Tesla900/CP_Inverter/PFC/Hardware/CP_inverter_front.png

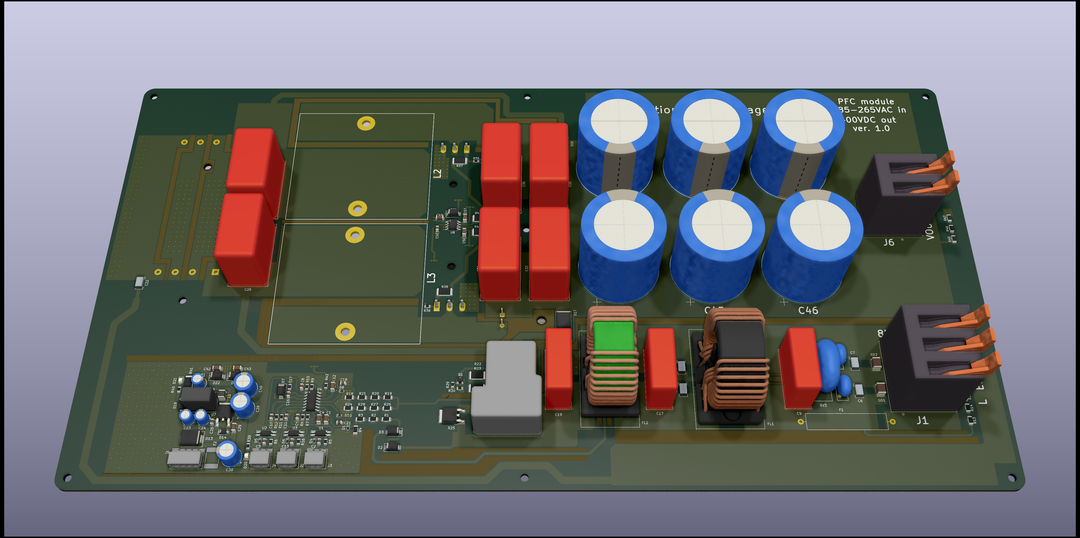
PFC/Hardware/CP_inverter_front.png
