Tesla900/CP_Inverter/PFC/Hardware/Info/CP_inverter_back.png

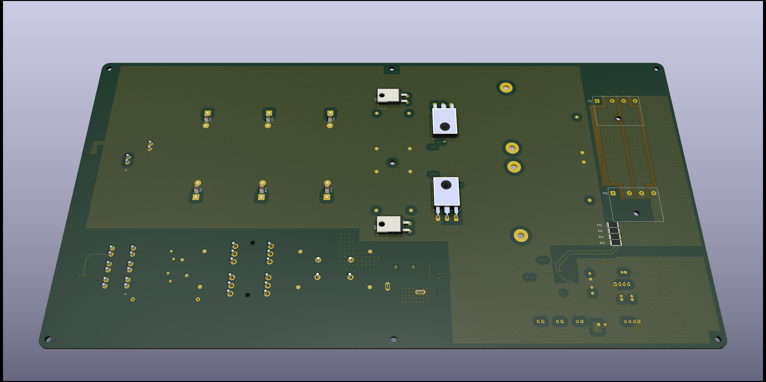
PFC/Hardware/Info/CP_inverter_back.png
