Tesla900/CP_Inverter/README.md

# CP_Inverter
Cathodic protection system project
