Tesla900/CP_Inverter/PFC/Hardware/Info/CP_inverter_front.png

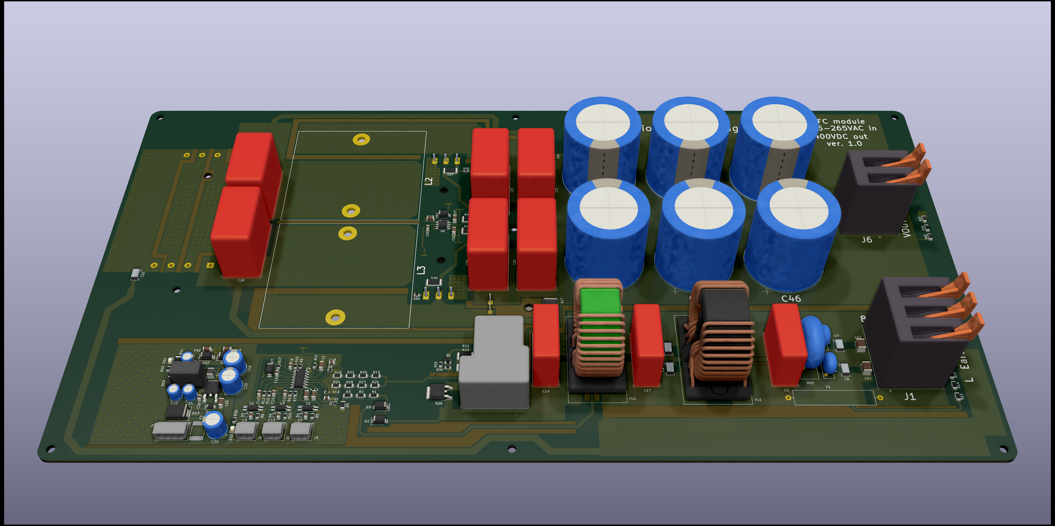
PFC/Hardware/Info/CP_inverter_front.png
