Tesla900/CP_Inverter/PSFB/Hardware/ProductionFiles/assembly/CP_Inverter_BOM.xlsx

Designator | PartNumber | Description | Value | Quantity | HelpURL
C1, C2, C3, C9, C11, C12, C14, C16, C17, C18, C32, C46, C47, C49, C51, C53, C54, C56, C58, C59, C60, C66, C68, C69, C71, C73, C74, C75, C81, C83, C84, C86, C88, C89, C90, C99, C100, C101, C102, C103 | CC1206KKX7R8BB106 | 10µF ±10% 25V Ceramic Capacitor X7R 1206 (3216 Metric) | 10μF | 40 | https://www.digikey.com/en/products/detail/yageo/CC1206KKX7R8BB106/5195365
C4, C7, C8, C15, C57, C72, C87 | CC0805JRNPO9BN270 | 27pF ±5% 50V Ceramic Capacitor C0G, NP0 0805 (2012 Metric) | 27pF | 7 | https://www.digikey.com/en/products/detail/yageo/CC0805JRNPO9BN270/302838
C5, C6, C50 | CC0805JKNPO7BN103 | 27pF ±5% 50V Ceramic Capacitor C0G, NP0 0805 (2012 Metric) | 10nF | 3 | https://www.digikey.com/en/products/detail/yageo/CC0805JKNPO7BN103/5884010
C10, C13, C52, C55, C67, C70, C82, C85, C96, C97, C98 | A750KS337M1EAAE018 | 330µF 25V Aluminum - Polymer Capacitors Radial, Can 18mOhm 2000 Hrs @ 105°C | 330μF | 11 | https://www.digikey.com/en/products/detail/kemet/A750KS337M1EAAE018/6196447
C19, C20, C21, C22, C23, C45, C48, C61, C62, C63, C64, C65, C76, C77, C78, C79, C80, C91, C92, C93, C94, C95 | CC0805JRNPO9BN101 | 100pF ±5% 50V Ceramic Capacitor C0G, NP0 0805 (2012 Metric) | 100pF | 22 | https://www.digikey.com/en/products/detail/yageo/CC0805JRNPO9BN101/302845
C24 | A750KS337M1EAAE018 | 22µF 450V Aluminum Electrolytic Capacitors Radial, Can 12000 Hrs @ 105°C | 22μF | 1 | https://www.digikey.com/en/products/detail/rubycon/450BXC22MEFC16X20/3564354
C25, C26, C27, C28 | 890303327008CS | 1.5µF Film Capacitor 630V Polypropylene (PP), Metallized RadialC | 1.5μF | 4 | https://www.digikey.com/en/products/detail/w%C3%BCrth-elektronik/890303327008CS/8324661
C29 | 8853522130111 | 1000pF ±10% 250V Ceramic Capacitor X7R 2211 (5728 Metric) | 1nF | 1 | https://www.digikey.com/en/products/detail/w%C3%BCrth-elektronik/8853522130111/6140841
C30, C39, C40, C41, C42, C43, C44 | CC1206KKX7R0BB225 | 2.2µF ±10% 100V Ceramic Capacitor X7R 1206 (3216 Metric) | 2.2μF | 7 | https://www.digikey.com/en/products/detail/yageo/CC1206KKX7R0BB225/5884563
C31 | CC0805KRX7R9BB104 | 0.1µF ±10% 50V Ceramic Capacitor X7R 0805 (2012 Metric) | 0.1μF | 1 | https://www.digikey.com/en/products/detail/yageo/CC0805KRX7R9BB104/302874
C33, C34, C35, C36, C37, C38 | LGY2A152MELB30 | 1500µF 100V Aluminum Electrolytic Capacitors Radial, Can - Snap-In 5000 Hrs @ 105°C | 1500μF | 6 | https://www.digikey.com/en/products/detail/nichicon/LGY2A152MELB30/2540916
D1 | B0303S-1WR2 | Isolated Module DC DC Converter 1 Output 3.3V 303mA 2.97V - 3.63V Input |  | 1 | https://lcsc.com/product-detail/Power-Modules_MORNSUN-Guangzhou-S-T-B0303S-1WR2_C70480.html
D2 | AMC1311BDWVR | Isolator amplifier |  | 1 | https://www.digikey.com/en/products/detail/texas-instruments/AMC1311BDWVR/8020495
D3, D9, D11, D13 | B2424S-1WR2 | Isolated Module DC DC Converter 1 Output 24V 42mA 21.6V - 26.4V Input |  | 4 | https://lcsc.com/product-detail/Power-Modules_MORNSUN-Guangzhou-S-T-B2424S-1WR2_C91799.html
D4, D10, D12, D14 | UCC21750DWR | 10A Gate Driver Capacitive Coupling 5700Vrms 1 Channel 16-SOIC |  | 4 | https://www.digikey.com/en/products/detail/texas-instruments/UCC21750DWR/11502037
D5 | CAS 50-NP | Current Sensor 50A 1 Channel Flux Gate, Closed Loop Bidirectional Module |  | 1 | https://www.digikey.com/en/products/detail/lem-usa-inc/CAS-50-NP/2038403
D6, D8 | 1EDN7512GXTMA1 | Low-Side Gate Driver IC Inverting, Non-Inverting PG-WSON-6-1 |  | 2 | https://www.digikey.com/en/products/detail/infineon-technologies/1EDN7512GXTMA1/6565754
D7 | AP2205-50W5-7 | Linear Voltage Regulator IC Positive Fixed 1 Output 250mA SOT-25 |  | 1 | https://www.digikey.com/en/products/detail/diodes-incorporated/AP2205-50W5-7/10294899
D15 | L7812CD2T-TR | Linear Voltage Regulator IC Positive Fixed 1 Output 1.5A D2PAK |  | 1 | https://www.digikey.com/en/products/detail/stmicroelectronics/L7812CD2T-TR/585702
D16 | LD1086D2T33TR | Linear Voltage Regulator IC Positive Fixed 1 Output 1.5A D2PAK |  | 1 | https://www.digikey.com/en/products/detail/stmicroelectronics/LD1086D2T33TR/585748
FU1 | C1Q 2.5 | 2.5A 125V AC 63V DC Fuse Board Mount (Cartridge Style Excluded) Surface Mount 1206 (3216 Metric) |  | 1 | https://www.digikey.com/en/products/detail/bel-fuse-inc/C1Q-2-5/615152
L1 | 0077930A7 | Custom inductor, DNP | *μH | 1 | http://ferrite.ru/warehouse/r-26-914-711-2-77930-a7.html
L2 | 0077438A7 | Custom inductor, DNP | *μH | 1 | http://ferrite.ru/warehouse/r-46-7-24-1-18-77438-a7.html
L3 | SDR0403-4R7ML | 4.7µH Unshielded Wirewound Inductor 1.7A 94mOhm Max Nonstandard | 4.7μH | 1 | https://www.digikey.com/product-detail/en/bourns-inc/SDR0403-4R7ML/SDR0403-4R7MLCT-ND/2127096
R1, R5, R13, R54, R69, R84 | RC0805JR-071KL | 1 kOhms ±5% 0.125W, 1/8W Chip Resistor 0805 (2012 Metric) Moisture Resistant Thick Film | 1K | 6 | https://www.digikey.com/en/products/detail/yageo/RC0805JR-071KL/728218
R2, R3, R4, R34 | RC0805FR-0749R9L | 49.9 Ohms ±1% 0.125W, 1/8W Chip Resistor 0805 (2012 Metric) Moisture Resistant Thick Film | 49.9R | 4 | https://www.digikey.com/en/products/detail/yageo/RC0805FR-0749R9L/727984
R6 | RC2512FK-0720R5L | 20.5 Ohms ±1% 1W Chip Resistor 2512 (6432 Metric) Moisture Resistant Thick Film | 20.5R | 1 | https://www.digikey.com/en/products/detail/yageo/RC2512FK-0720R5L/5921990
R7, R48, R63, R78 | RC2512JK-07220RL | 220 Ohms ±5% 1W Chip Resistor 2512 (6432 Metric) Moisture Resistant Thick Film | 220R | 4 | https://www.digikey.com/en/products/detail/yageo/RC2512JK-07220RL/5922529
R8, R20, R21, R23, R24, R30, R31, R38, R39, R40, R42, R45, R46, R49, R61, R62, R64, R76, R77, R79, R91, R92 | RC0805FR-0710KL | 10 kOhms ±1% 0.125W, 1/8W Chip Resistor 0805 (2012 Metric) Moisture Resistant Thick Film | 10K | 22 | https://www.digikey.com/en/products/detail/yageo/RC0805FR-0710KL/727535
R9, R10, R11, R50, R51, R52, R65, R66, R67, R80, R81, R82 | RC0805JR-074K7L | 4.7 kOhms ±5% 0.125W, 1/8W Chip Resistor 0805 (2012 Metric) Moisture Resistant Thick Film | 4.7K | 12 | https://www.digikey.com/en/products/detail/yageo/RC0805JR-074K7L/728327
R12, R14, R16, R17, R19, R37, R44, R53, R55, R57, R58, R60, R68, R70, R72, R73, R75, R83, R85, R87, R88, R90 | RC0805JR-07100RL | 100 Ohms ±5% 0.125W, 1/8W Chip Resistor 0805 (2012 Metric) Moisture Resistant Thick Film | 100R | 22 | https://www.digikey.com/product-detail/en/yageo/RC0805JR-07100RL/311-100ARCT-ND/731185
R15, R18, R56, R59, R71, R74, R86, R89 | RC2512JK-07100RL | 500 mOhms ±5% 1W Chip Resistor 2512 (6432 Metric) Automotive AEC-Q200, Current Sense, Moisture Resistant Thick Film | 0.5R | 8 | https://www.digikey.com/en/products/detail/yageo/RL2512JK-070R5L/5925490
R22, R25, R28 | RC1206FR-071ML | 1 MOhms ±1% 0.25W, 1/4W Chip Resistor 1206 (3216 Metric) Moisture Resistant Thick Film | 1M | 3 | https://www.digikey.com/en/products/detail/yageo/RC1206FR-071ML/728388
R26, R27, R32 | RC2512FK-07499RL | 499 Ohms ±1% 1W Chip Resistor 2512 (6432 Metric) Moisture Resistant Thick Film | 499R | 3 | https://www.digikey.com/en/products/detail/yageo/RC2512FK-07499RL/5922242
R29 | RC1206FR-0716K2L | 16.2 kOhms ±1% 0.25W, 1/4W Chip Resistor 1206 (3216 Metric) Moisture Resistant Thick Film | 16.2K | 1 | https://www.digikey.com/en/products/detail/yageo/RC1206FR-0716K2L/728570
R33 | RC1206JR-07100KL | 100 kOhms ±5% 0.25W, 1/4W Chip Resistor 1206 (3216 Metric) Moisture Resistant Thick Film | 100K | 1 | https://www.digikey.com/en/products/detail/yageo/RC1206JR-07100KL/729207
R35, R41 | RL1206JR-070R5L | 500 mOhms ±5% 0.25W, 1/4W Chip Resistor 1206 (3216 Metric) Automotive AEC-Q200, Current Sense, Moisture Resistant Thick Film | 0.5R | 2 | https://www.digikey.com/en/products/detail/yageo/RL1206JR-070R5L/5925150
R36, R43 | RC1206JR-073R3L | 3.3 Ohms ±5% 0.25W, 1/4W Chip Resistor 1206 (3216 Metric) Moisture Resistant Thick Film | 3.3R | 2 | https://www.digikey.com/en/products/detail/yageo/RC1206JR-073R3L/729266
R47 | RC0805FR-07412RL | 412 Ohms ±1% 0.125W, 1/8W Chip Resistor 0805 (2012 Metric) Moisture Resistant Thick Film | 412R | 1 | https://www.digikey.com/en/products/detail/yageo/RC0805FR-07412RL/727946
T1 | P8208NLT | 1:100 Current Sense Transformer 50kHz ~ 1MHz 6mOhm Primary, 5.5Ohm Secondary 2mH Surface Mount |  | 1 | https://www.digikey.com/product-detail/en/pulse-electronics-power/P8208NLT/553-1523-1-ND/2362921
T2 | B66398W1024T001 | N97 B66397G0000X197 сore / B66398W1024T001 coil former, DNP |  | 1 | https://www.digikey.com/en/products/detail/epcos-tdk-electronics/B66398W1024T001/3914904
VD1, VD2, VD4, VD27 | PESD3V3L1BA | 3.3V Reverse Standoff 26V Clamp 18A (8/20µs) Ipp Tvs Diode Surface Mount SOD-323 |  | 4 | https://www.digikey.com/en/products/detail/nexperia-usa-inc/PESD3V3L1BA-115/1157438
VD3 | BAT46WQ-7-F | Diode Schottky 100V 150mA Surface Mount SOD-123 |  | 1 | https://www.digikey.com/en/products/detail/diodes-incorporated/BAT46WQ-7-F/6003945
VD5, VD11, VD23, VD25, VD28, VD34, VD38, VD44, VD48, VD54 | 1N5819HW-7-F | Diode Schottky 40V 1A Surface Mount SOD-123C |  | 10 | https://www.digikey.com/en/products/detail/diodes-incorporated/1N5819HW-7-F/814970
VD6, VD29, VD39, VD49 | SMAZ16-13-F | Zener Diode 16V 1W ±5% Surface Mount SMA |  | 4 | https://www.digikey.com/en/products/detail/diodes-incorporated/SMAZ16-13-F/808526
VD7, VD30, VD40, VD50 | LTST-C171KRKT | Red 631nm LED Indication - Discrete 2V 0805 (2012 Metric) |  | 4 | https://www.digikey.com/en/products/detail/lite-on-inc/LTST-C171KRKT/386801
VD8, VD31, VD41, VD51 | SMAZ5V1-13-F | Zener Diode 5.1V 1W ±5% Surface Mount SMA |  | 4 | https://www.digikey.com/en/products/detail/diodes-incorporated/SMAZ5V1-13-F/725036
VD9, VD10, VD32, VD33, VD42, VD43, VD52, VD53 | STTH112A | Diode Standard 1200V 1A Surface Mount SMA |  | 8 | https://www.digikey.com/en/products/detail/stmicroelectronics/STTH112A/1039767
VD12, VD35, VD45, VD55 | MMSZ5242B | Zener Diode 12V 500mW ±5% Surface Mount SOD-123 |  | 4 | https://www.digikey.com/en/products/detail/on-semiconductor/MMSZ5242B/1048676
VD13, VD14, VD36, VD37, VD46, VD47, VD56, VD57 | LTST-C170GKT | Green 571nm LED Indication - Discrete 2V 0805 (2012 Metric) |  | 8 | https://www.digikey.com/en/products/detail/lite-on-inc/LTST-C171KGKT/386799
VD15, VD17, VD18, VD19, VD24, VD26 | SMBJ18CA | 29.2V Clamp 20.6A Ipp Tvs Diode Surface Mount DO-214AA (SMBJ) |  | 6 | https://www.digikey.com/en/products/detail/littelfuse-inc/SMBJ18CA/285986
VD16, VD20 | C6D04065E | Diode Silicon Carbide Schottky 650V 8A (DC) Surface Mount TO-252-2 |  | 2 | https://www.digikey.com/en/products/detail/cree-wolfspeed/C6D04065E/12525322
VD21, VD22 | MBRS4201T3G | Diode Schottky 200V 4A Surface Mount SMC |  | 2 | https://www.digikey.com/en/products/detail/on-semiconductor/MBRS4201T3G/1087352
VD58 | B340LB-13-F | Diode Schottky 40V 3A Surface Mount SMB |  | 1 | https://www.digikey.com/en/products/detail/diodes-incorporated/B340LB-13-F/755461
VD59 | SMBJ28CA | 45.4V Clamp 13.3A Ipp Tvs Diode Surface Mount DO-214AA (SMBJ) |  | 1 | https://www.digikey.com/en/products/detail/littelfuse-inc/SMBJ28CA/286003
VT1, VT2, VT3, VT4 | C3M0120065D | N-Channel 650V 22A (Tc) 98W (Tc) SiC MOSFET Through Hole TO-247-3 |  | 4 | https://www.richardsonrfpd.com/Products/Product/C3M0120065D
VT5, VT6 | IPT012N08N5ATMA1 | N-Channel 80V 300A (Tc) 375W (Tc) Surface Mount PG-HSOF-8-1 |  | 2 | https://www.digikey.com/en/products/detail/IPT012N08N5ATMA1/IPT012N08N5ATMA1CT-ND/5413752
X1, X2, X9, X12 | 60311002111526 | SMA Connector Jack, Female Socket 50Ohm Through Hole Solder |  | 4 | https://www.we-online.com/catalog/en/WR-SMA_60311002111526
X3 | 2453690000 | 2 Position Wire to Board Terminal Block Horizontal with Board 0.394" (10.00mm) Through Hole |  | 1 | https://www.digikey.com/en/products/detail/weidm%C3%BCller/2453690000/9637690
X4, X5, X6, X7 | SM06B-GHS | Connector Header Surface Mount, Right Angle 6 position 0.039" (1.00mm) |  | 4 | https://www.digikey.com/product-detail/en/jst-sales-america-inc/SM06B-GHS-TB-LF-SN/455-1568-1-ND/807836
X8, X13 | 7461098 | 25 Pin Shank Terminal M6 Through Hole |  | 2 | https://www.digikey.com/en/products/detail/w%C3%BCrth-elektronik/7461098/2092196
X10, X11 | SM02B-SRSS-TB(LF)(SN) | Connector Header Surface Mount, Right Angle 2 position 0.039" (1.00mm) |  | 2 | https://www.digikey.com/en/products/detail/jst-sales-america-inc/SM02B-SRSS-TB-LF-SN/926708
X14 | 6PCV-02-006 | 2 Circuit 0.375" (9.53mm) Barrier Block Connector, Screws |  | 1 | https://www.digikey.com/en/products/detail/te-connectivity-amp-connectors/6PCV-02-006/1277933
