Tesla900/CP_Inverter/PFC/Hardware/ProductionFiles/assembly/CP_Inverter_BOM.xlsx

Reference | Value/PartNumber | PartNumber | Qty | Description | Link | DoNotPlace Status
C2, C3, C11, C13, C26, C34 | 0.1uF | CC0805KRX7R9BB104 | 6 | 0.1µF ±10% 50V Ceramic Capacitor X7R 0805 (2012 Metric) | https://www.digikey.com/en/products/detail/yageo/CC0805KRX7R9BB104/302874
C10, C16 | 4.7nF | CC0805JKNPO8BN472 | 2 | 4700pF ±5% 25V Ceramic Capacitor C0G, NP0 0805 (2012 Metric) | https://www.digikey.com/en/products/detail/yageo/CC0805JKNPO8BN472/5884015
C6, C7, C14, C15 | 2.2nF | 8853522130151 | 4 | 2200pF ±10% 250V Ceramic Capacitor X7R 2211 (5728 Metric) | ttps://www.digikey.com/en/products/detail/würth-elektronik/8853522130151/6140842
C5, C8, C18 | 10nF | CC0805JKNPO7BN103 | 3 | 10nF ±5% 16V Ceramic Capacitor C0G, NP0 0805 (2012 Metric) | https://www.digikey.com/en/products/detail/yageo/CC0805JKNPO7BN103/5884010
C9, C17, C19 | 1.5uF | 890334026030 | 3 | 1.5µF Film Capacitor 310V Polypropylene (PP), X2 Rated, Metallized Radial | https://www.digikey.com/en/products/detail/w%C3%BCrth-elektronik/890334026030/5038988
C22, C55 | 1nF | 8853522130111 | 2 | 1000pF ±10% 250V Ceramic Capacitor X7R 2211 (5728 Metric) | https://www.digikey.com/en/products/detail/w%C3%BCrth-elektronik/8853522130111/6140841
C23, C24, C31 | 22uF | A768EB226M1HLAE048 | 3 | 22µF 35V Aluminum - Polymer Capacitors Radial, Can 80mOhm 2000 Hrs @ 125°C | https://www.digikey.com/en/products/detail/kemet/A759BQ226M1VAAE080/6196509
C27, C28, C32, C33, C35, C36 | 1.5uF | 890303327008CS | 6 | 1.5µF Film Capacitor 630V Polypropylene (PP), Metallized Radial | https://www.digikey.com/en/products/detail/w%C3%BCrth-elektronik/890303327008CS/8324661
C30, C39, C40 | 330uF | A750KS337M1EAAE018 | 3 | 330µF 25V Aluminum - Polymer Capacitors Radial, Can 18mOhm 2000 Hrs @ 105°C | https://www.digikey.com/en/products/detail/kemet/A750KS337M1EAAE018/6196447
C37, C38, C41, C44-C46 | 330uF | ETXH451VSN331MA40S | 6 | 330µF 450V Aluminum Electrolytic Capacitors Radial, Can - Snap-In 10000 Hrs @ 105°C | https://www.digikey.com/en/products/detail/united-chemi-con/ETXH451VSN331MA40S/5824661
C1, C4, C12, C20, C25, C29, C42, C43, C49, C56, C57 | 10uF | CC1206KKX7R8BB106 | 11 | 10µF ±10% 25V Ceramic Capacitor X7R 1206 (3216 Metric) | https://www.digikey.com/en/products/detail/yageo/CC1206KKX7R8BB106/5195365
C21, C50 | 22pF | CC0805JRNPO9BN220 | 2 | 22pF ±5% 50V Ceramic Capacitor C0G, NP0 0805 (2012 Metric) | https://www.digikey.com/en/products/detail/yageo/CC0805JRNPO9BN220/302837
C47, C48, C51-C54 | 0.1uF | C1210C104KBRACAUTO | 6 | 0.1µF ±10% 630V Ceramic Capacitor X7R 1210 (3225 Metric) | https://www.digikey.com/en/products/detail/kemet/C1210C104KBRACAUTO/7516214
D2, D3, D7, D19, D24 | MRA4007T3G | MRA4007T3G | 5 | Diode Standard 1000V 1A Surface Mount DO-214AC (SMA) | https://www.digikey.com/en/products/detail/on-semiconductor/MRA4007T3G/919869
D1, D4-D6, D8, D10 | PESD5V0L1UB,115 | PESD5V0L1UB,115 | 6 | 12V Clamp 3.5A (8/20µs) Ipp Tvs Diode Surface Mount SOD-523 | https://www.digikey.com/en/products/detail/nexperia-usa-inc/PESD5V0L1UB115/2092297
D11, D12 | 50A | TS50P07GHD2G | 2 | Bridge Rectifier Single Phase Standard 1kV 50A Through Hole TS-6P | https://www.digikey.com/en/products/detail/taiwan-semiconductor-corporation/TS50P07G-D2G/7359823
D13 | SMCJ30A | SMCJ30A | 1 | 48.4V Clamp 31A Ipp Tvs Diode Surface Mount DO-214AB (SMCJ) | https://www.digikey.com/en/products/detail/littelfuse-inc/SMCJ30A/762400
D9, D14 | 1N5819 | 1N5819HW-7-F | 2 | Diode Schottky 40V 1A Surface Mount SOD-123 | https://www.digikey.com/en/products/detail/diodes-incorporated/1N5819HW-7-F/814970
D15, D17 | S15MC V7G | S15MC V7G | 2 | Diode Standard 1000V 15A Surface Mount DO-214AB (SMC) | https://www.digikey.com/en/products/detail/taiwan-semiconductor-corporation/S15MC-V7G/7358295
D16, D18 | C6D10065A | C6D10065A | 2 | Diode Silicon Carbide Schottky 650V 37A (DC) Through Hole TO-220-2 | https://www.digikey.com/en/products/detail/C6D10065A/1697-C6D10065A-ND/10223723
D20, D21 | GREEN | LTST-S220KGKT | 2 | Green 568nm LED Indication - Discrete 2V 0805 (2012 Metric) | https://www.digikey.com/en/products/detail/lite-on-inc/LTST-S220KGKT/386875
D22 | 15V | SMAZ15 | 1 | Zener Diode 15V 1W ±5% Surface Mount SMA | https://www.digikey.com/en/products/detail/diodes-incorporated/SMAZ15-13-F/775753
D23 | 5.1V | SMAZ5V1 | 1 | Zener Diode 5.1V 1W ±5% Surface Mount SMA | https://www.digikey.com/en/products/detail/diodes-incorporated/SMAZ5V1-13-F/725036
F1 | 50A | SUT-H-6332-50A00-PGT-TT-NI | 1 | 50A 250V AC 70V DC Fuse Cartridge, Ceramic Through Hole 3AB, 3AG, 1/4" x 1-1/4" (Axial) | https://www.digikey.com/en/products/detail/schurter-inc/SUT-H-6332-50A00-PGT-TT-NI/9760595
F2 | 1A | 0ZCF0100AF2A | 1 | Polymeric PTC Resettable Fuse 60V 1A Ih Surface Mount 2920 (7351 Metric), Concave | https://www.digikey.com/en/products/detail/bel-fuse-inc/0ZCF0100AF2A/6210541
FL1 | 1.5mH@10kHz | 7448063801 | 1 | 1.5mH @ 10kHz 2 Line Common Mode Choke Through Hole 38A DCR 2.3mOhm | https://www.digikey.com/en/products/detail/w%C3%BCrth-elektronik/7448063801/4865370
FL2 | 500uH@10kHz | 7448263505 | 1 | 500µH @ 100kHz 2 Line Common Mode Choke Through Hole 35A DCR 2.3mOhm | https://www.digikey.com/en/products/detail/w%C3%BCrth-elektronik/7448263505/2682534
GD1, GD2 | SG500Q | SG500Q | 2 | Gas Discharge Tube 500V 1000A (1kA) 2 Pole Surface Mount | https://www.digikey.com/en/products/detail/littelfuse-inc/SG500Q/4286095
R31, R32 | ~ | ~ | 9 | ~ | ~ | DNP
J1 | 1988610000 | 1988610000 | 1 | 3 Position Wire to Board Terminal Block Horizontal with Board 0.394" (10.00mm) Through Hole | https://www.digikey.com/en/products/detail/weidm%C3%BCller/1988610000/9637680
J2-J4 | 0022057025 | 0022057025 | 3 | Connector Header Through Hole, Right Angle 2 position 0.098" (2.50mm) | https://www.digikey.com/en/products/detail/molex/0022057025/403341
J5 | 0022057045 | 0022057045 | 1 | Connector Header Through Hole, Right Angle 4 position 0.098" (2.50mm) | https://www.digikey.com/en/products/detail/molex/0022057045/403343
J6 | 2453690000 | 2453690000 | 1 | 2 Position Wire to Board Terminal Block Horizontal with Board 0.394" (10.00mm) Through Hole | https://www.digikey.com/en/products/detail/weidm%C3%BCller/2453690000/9637690
L1 | 6.8uH | LBC3225T6R8MR | 1 | 6.8µH Unshielded Wirewound Inductor 620mA 120mOhm 1210 (3225 Metric) | https://www.digikey.com/en/products/detail/taiyo-yuden/LBC3225T6R8MR/2230218
L2, L3 | 250uH | 0058620A2 | 2 | Custom 25A 250uH inductor. Use 2 stacked HighFlux cores (KS250-060A or 0077617A7) and make 22 turns with 2.5mm2 emal wire | https://www.mag-inc.com/Media/Magnetics/Datasheets/0058620A2.pdf
Q1 | IRLML0030TRPBF | IRLML0030TRPBF | 1 | N-Channel 30V 5.3A (Ta) 1.3W (Ta) Surface Mount Micro3™/SOT-23 | https://www.digikey.com/en/products/detail/infineon-technologies/IRLML0030TRPBF/2202215
Q2, Q3 | C3M0060065D | C3M0060065D | 2 | N-Channel SiC 650V 37A (Tc) 150W (Tc) Through Hole TO-247-3 | https://www.digikey.com/en/products/detail/cree-wolfspeed/C3M0060065D/12525330
R4 | 47.5K | RC1206FR-0747K5L | 1 | 47.5 kOhms ±1% 0.25W, 1/4W Chip Resistor 1206 (3216 Metric) Thick Film | https://www.digikey.com/en/products/detail/yageo/RC1206FR-0747K5L/728933
R5, R6, R11, R16, R29 | 470R | RC0805JR-07470RL | 5 | 470 Ohms ±5% 0.125W, 1/8W Chip Resistor 0805 (2012 Metric) Thick Film | https://www.digikey.com/en/products/detail/yageo/RC0805JR-07470RL/728333
R8 | 6.2K | RC0805FR-076K2L | 1 | 6.2 kOhms ±1% 0.125W, 1/8W Chip Resistor 0805 (2012 Metric) Thick Film | https://www.digikey.com/en/products/detail/yageo/RC0805FR-076K2L/728055
R9, R10 | 200K | RC0805FR-07200KL | 2 | 200 kOhms ±1% 0.125W, 1/8W Chip Resistor 0805 (2012 Metric) Thick Film | https://www.digikey.com/en/products/detail/yageo/RC0805FR-07200KL/727724
R12 | 47.5K | RC0805FR-0747K5L | 1 | 10 kOhms ±5% 0.125W, 1/8W Chip Resistor 0805 (2012 Metric) Thick Film | https://www.digikey.com/en/products/detail/yageo/RC0805FR-0747K5L/727975
R17 | 68R | RC0805FR-0768RL | 1 | 100 Ohms ±1% 0.125W, 1/8W Chip Resistor 0805 (2012 Metric) Thick Film | https://www.digikey.com/en/products/detail/yageo/RC0805FR-0768RL/728097
R18 | 18.7K | RC1206FR-0718K7L | 1 | 18.7 kOhms ±1% 0.25W, 1/4W Chip Resistor 1206 (3216 Metric) Thick Film | https://www.digikey.com/en/products/detail/yageo/RC1206FR-0718K7L/728596
R1-R3, R13-R15, R19-R21, R26-R28, R45-R47 | 1M | RC1206FR-071ML | 15 | 1 MOhms ±1% 0.25W, 1/4W Chip Resistor 1206 (3216 Metric) Thick Film | https://www.digikey.com/en/products/detail/yageo/RC1206FR-071ML/728388
R22, R23 | 33R | SR2512FK-7W33RL | 2 | 33 Ohms ±1% 2W Chip Resistor 2512 (6432 Metric) Automotive AEC-Q200, Pulse Withstanding Thick Film | https://www.digikey.com/en/products/detail/yageo/SR2512FK-7W33RL/9373196
R24 | 17.4K | RC1206FR-0717K4L | 1 | 17.4 kOhms ±1% 0.25W, 1/4W Chip Resistor 1206 (3216 Metric) Thick Film | https://www.digikey.com/en/products/detail/yageo/RC1206FR-0717K4L/728584
R25 | 25R | PWR163S-25-25R0FE | 1 | 25 Ohms ±1% 25W Chip Resistor TO-252-3, DPak (2 Leads + Tab), SC-63 Automotive AEC-Q200, Current Sense, Pulse Withstanding Thick Film | https://www.digikey.com/en/products/detail/bourns-inc/PWR163S-25-25R0FE/4699567
R33, R34 | 0.009R | SY2512CFR009 | 2 | 9 mOhms ±1% ±50ppm/°C 3W Chip Resistor 2512 (6432 Metric), Current Sense, Thick Film | https://lcsc.com/product-detail/Low-Resistors-Current-Sense-Resistors-Surface-Mount_SANYEAR-SY2512CFR009_C457123.html
R7, R30, R35, R36, R39, R40 | 10K | RC0805JR-0710KL | 6 | 10 kOhms ±5% 0.125W, 1/8W Chip Resistor 0805 (2012 Metric) Thick Film | https://www.digikey.com/en/products/detail/yageo/RC0805JR-0710KL/728241
R37, R38, R43, R44 | 0.5R | RL2512JK-070R5L | 4 | 500 mOhms ±5% 1W Chip Resistor 2512 (6432 Metric) Automotive AEC-Q200, Current Sense, Moisture Resistant Thick Film | https://www.digikey.com/en/products/detail/yageo/RL2512JK-070R5L/5925490
R41 | 220R | RC2512JK-07220RL | 1 | 220 Ohms ±5% 1W Chip Resistor 2512 (6432 Metric) Thick Film | https://www.digikey.com/en/products/detail/yageo/RC2512JK-07220RL/5922529
R42 | 100R | RC0805FR-07100RL | 1 | 100 Ohms ±1% 0.125W, 1/8W Chip Resistor 0805 (2012 Metric) Thick Film | https://www.digikey.com/en/products/detail/yageo/RC0805FR-07100RL/727543
RV1, RV2 | 820471511 | 820471511 | 2 | 240V 1.75kA Varistor 1 Circuit Through Hole Disc 7mm | https://www.digikey.com/en/products/detail/würth-elektronik/820471511/9817446
RV3 | 820422711 | 820422711 | 1 | 430V 10kA Varistor 1 Circuit Through Hole Disc 20mm | https://www.digikey.com/en/products/detail/w%C3%BCrth-elektronik/820422711/9817436
U1-U3 | LTV-217-C | LTV-217-C-G | 3 | Optoisolator Transistor Output 3750Vrms 1 Channel 4-SSOP | https://www.digikey.com/en/products/detail/lite-on-inc/LTV-217-C-G/4573246
U4 | ICE3PCS01G | ICE3PCS01G | 1 | PFC IC Continuous Conduction (CCM) 21kHz - 100kHz PG-DSO-14 | https://www.digikey.com/en/products/detail/infineon-technologies/ICE3PCS01GXUMA1/5413671
U5 | T9VV1K15-12S | T9VV1K15-12S | 1 | General Purpose Relay SPST-NO (1 Form A) 40A 12VDC Coil Through Hole | https://www.digikey.com/en/products/detail/te-connectivity-potter-brumfield-relays/T9VV1K15-12S/7793533
U6 | L7815ACD2T | L7815ACD2T | 1 | Linear Voltage Regulator IC 1 Output 15V 1.5A D2PAK | https://www.digikey.com/en/products/detail/stmicroelectronics/L7815ACD2T-TR/1663423
U7 | B2424-1WR2 | B2424S-1WR2 | 1 | Isolated Module DC/DC Converter 1 Output 24V 42mA 21.6V - 26.4V Input | https://lcsc.com/product-detail/Power-Modules_MORNSUN-Guangzhou-S-T-B2424S-1WR2_C91799.html
U8 | UCC5390SCD | UCC5390SCD | 1 | 17A Gate Driver Capacitive Coupling 3000Vrms 1 Channel 8-SOIC | https://www.digikey.com/en/products/detail/texas-instruments/UCC5390SCD/8106211
DNP -Do Not Place
