Tesla900/CP_Inverter/PSFB/Hardware/Info/PSFB_Schematic Print.PDF

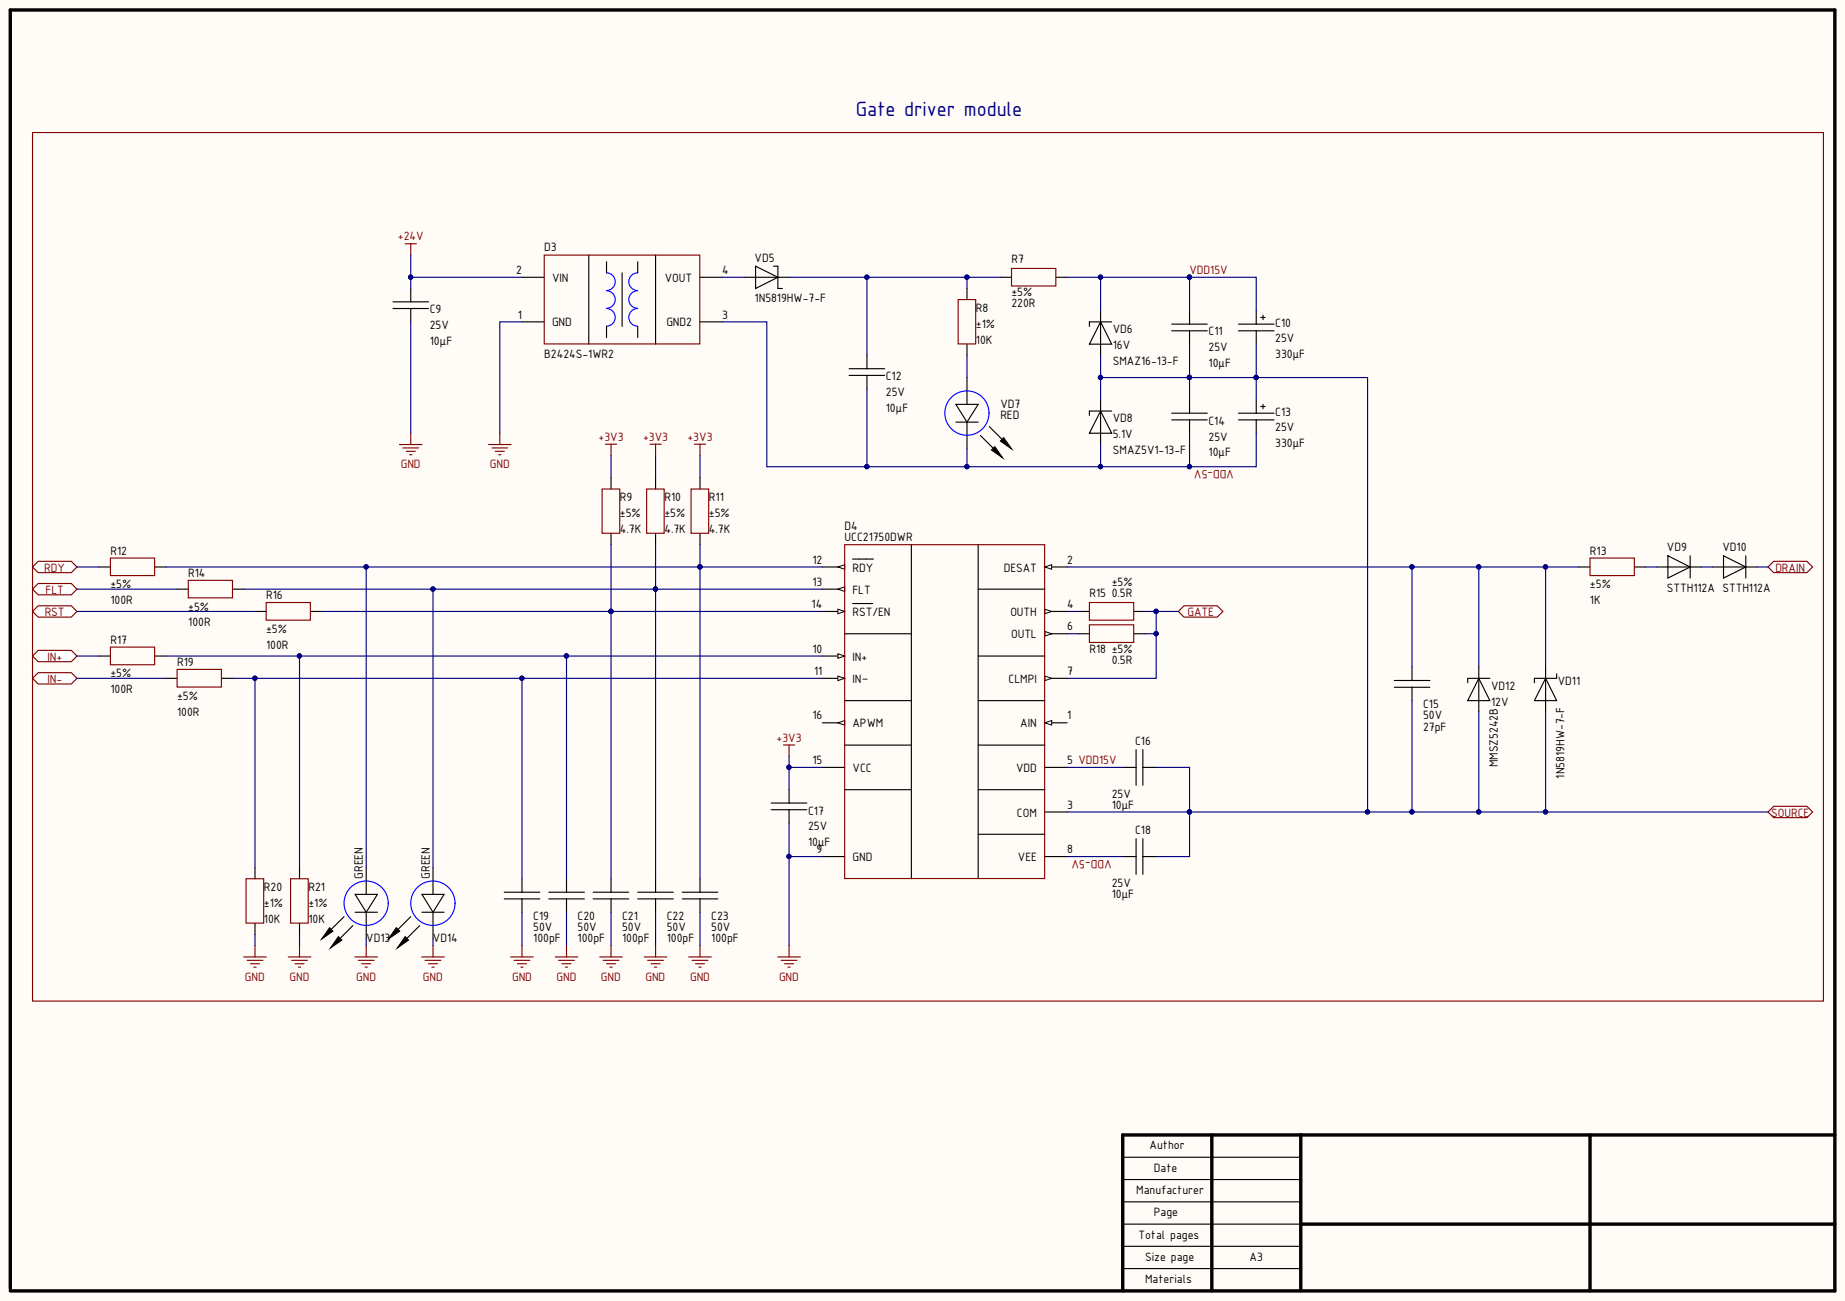
[picture p4: page 1]

+3V3 | APWM 16 | 1 C16

Author

Date

Manufacturer

Page

Total pages

Size page | A3

Materials

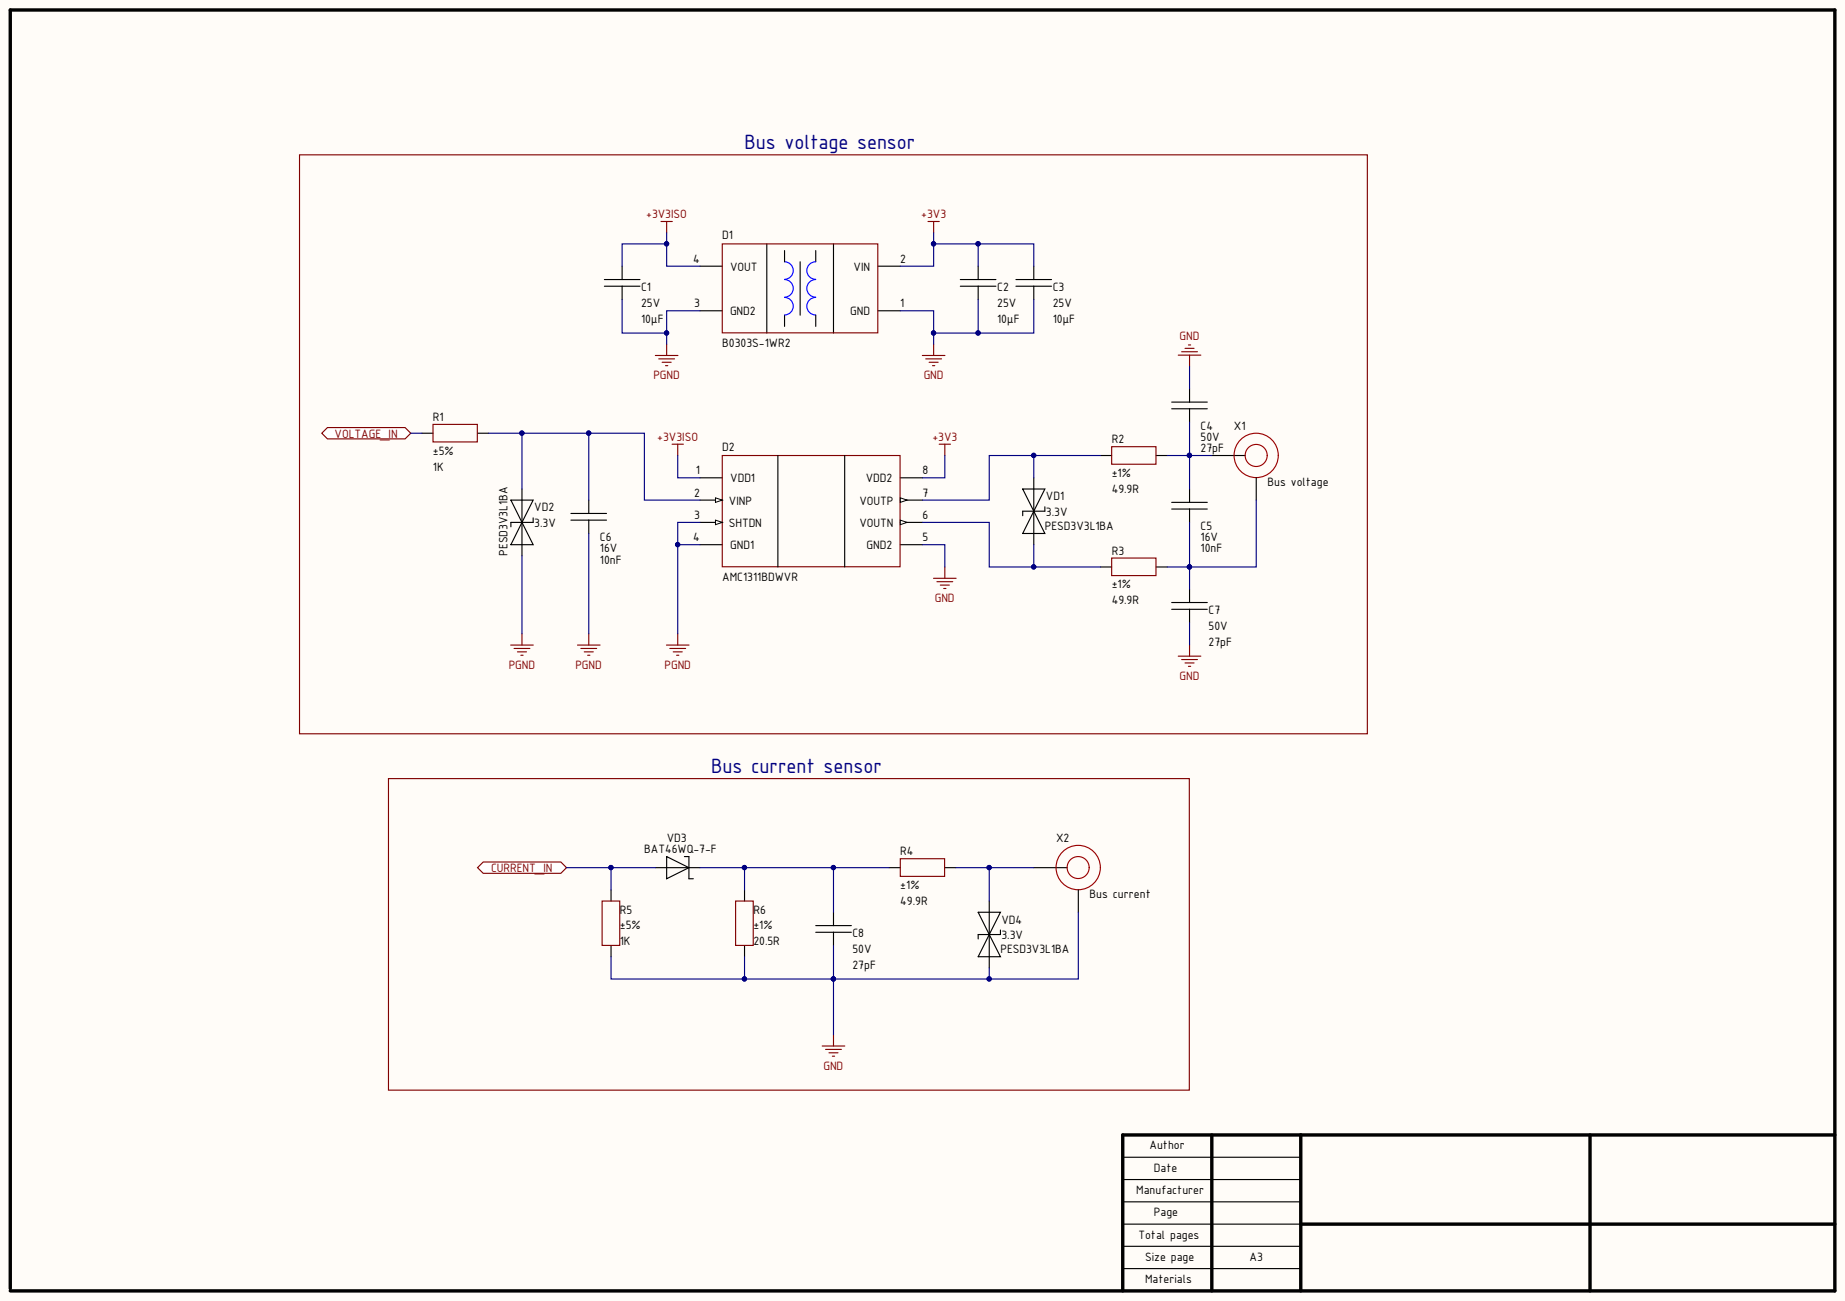
[picture p5: page 2]

Author

Date

Manufacturer

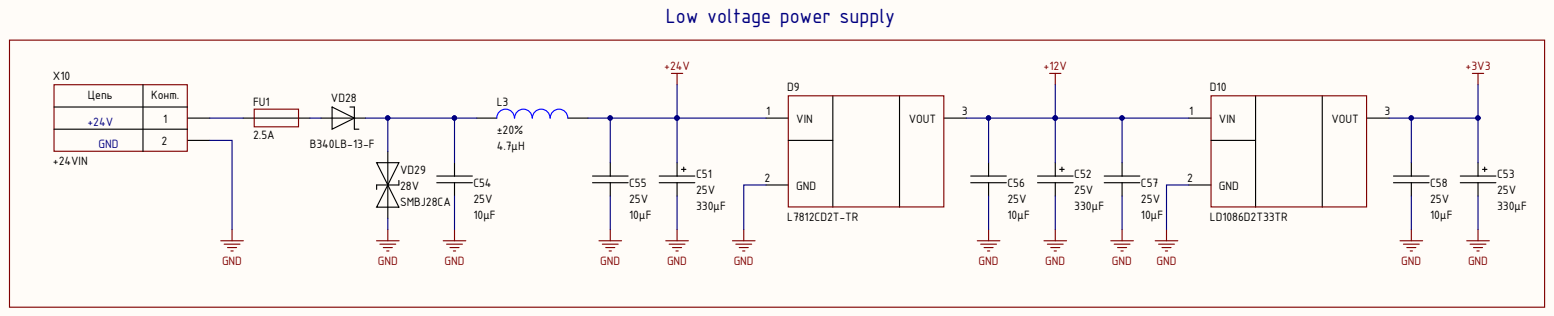
[picture p6: page 3]

Low voltage power supply

GND

Author

Date

Manufacturer

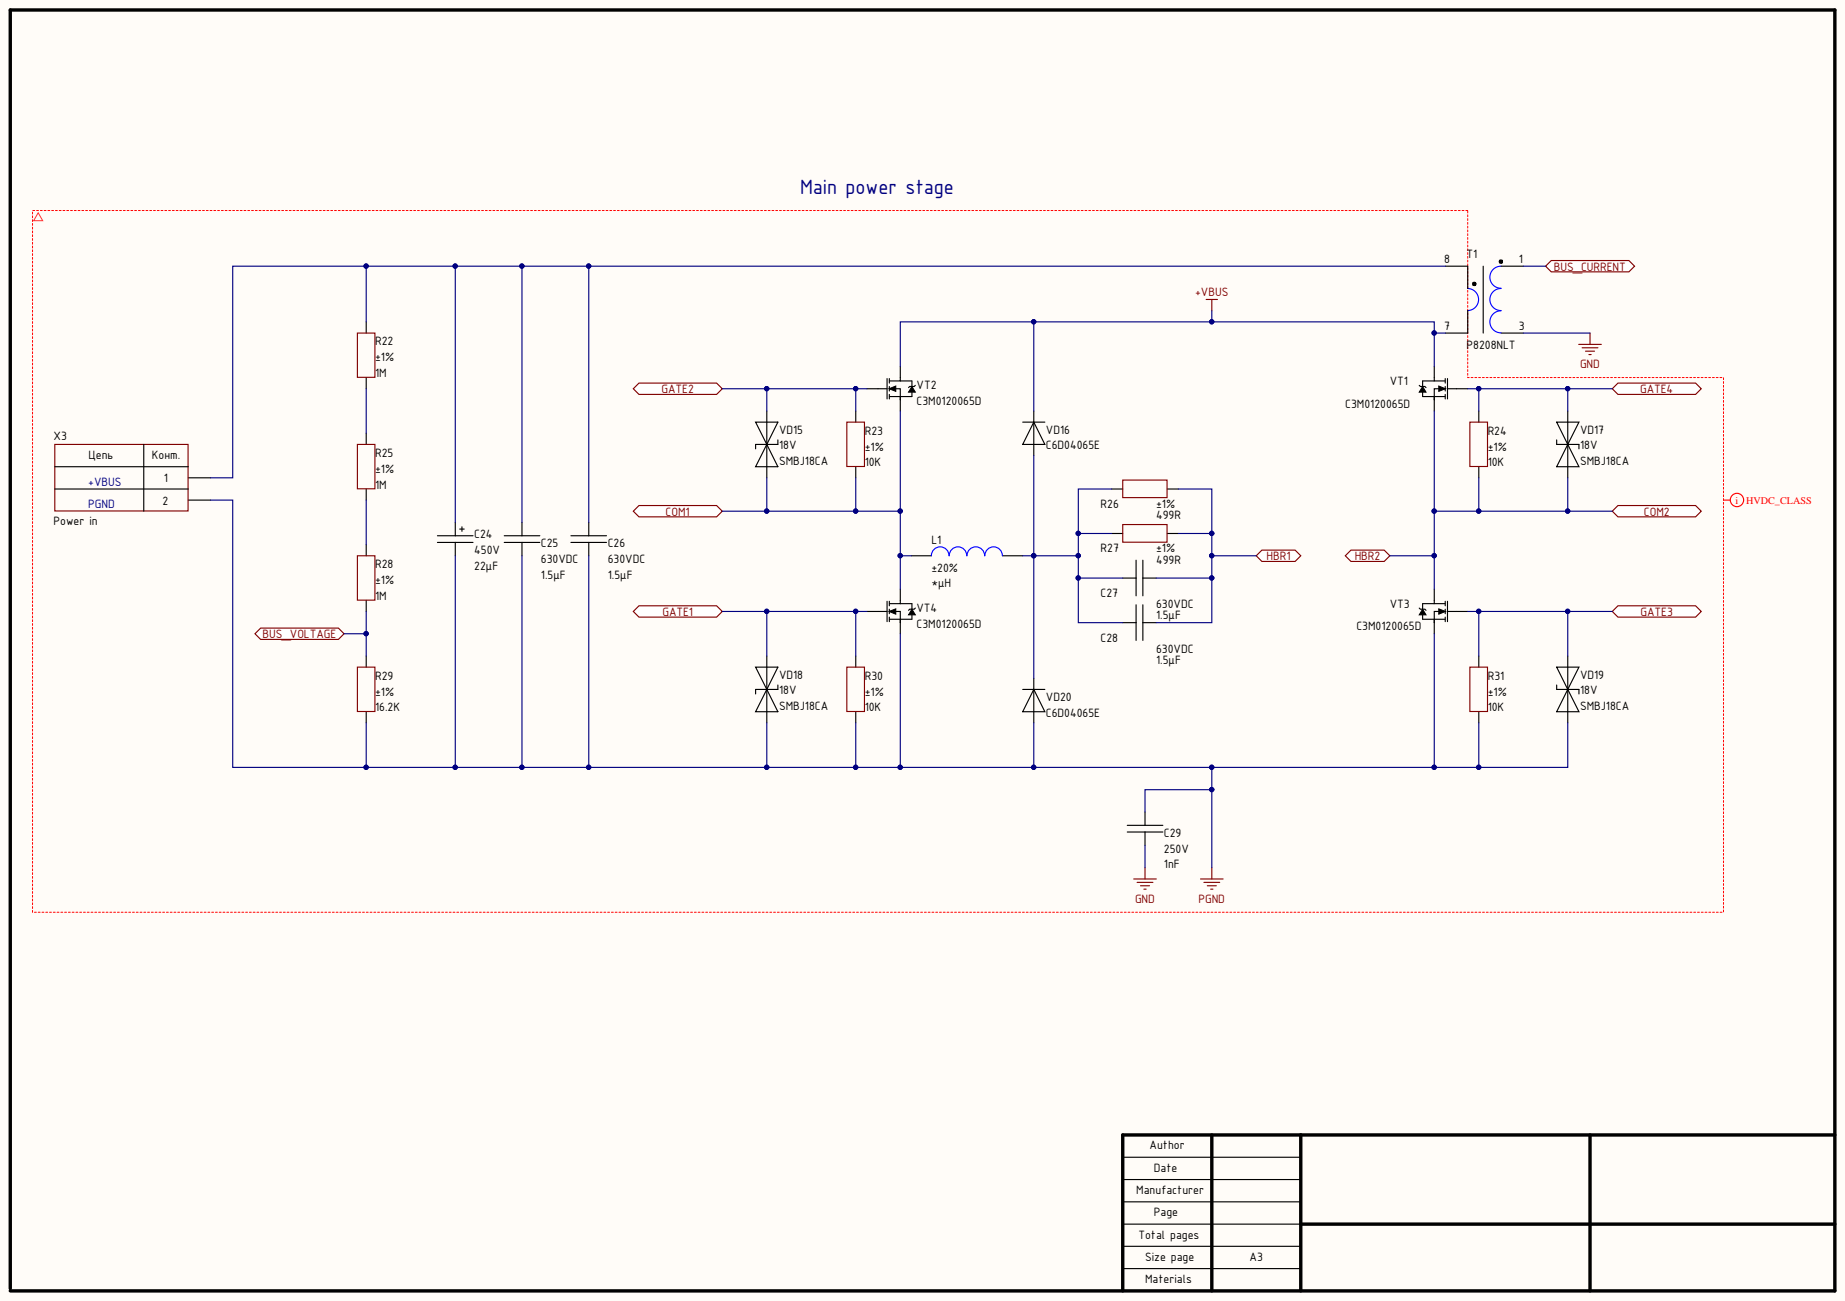
[picture p7: page 4]

Цепь | Конт .

+VBUS | 12

Author

Date

Manufacturer

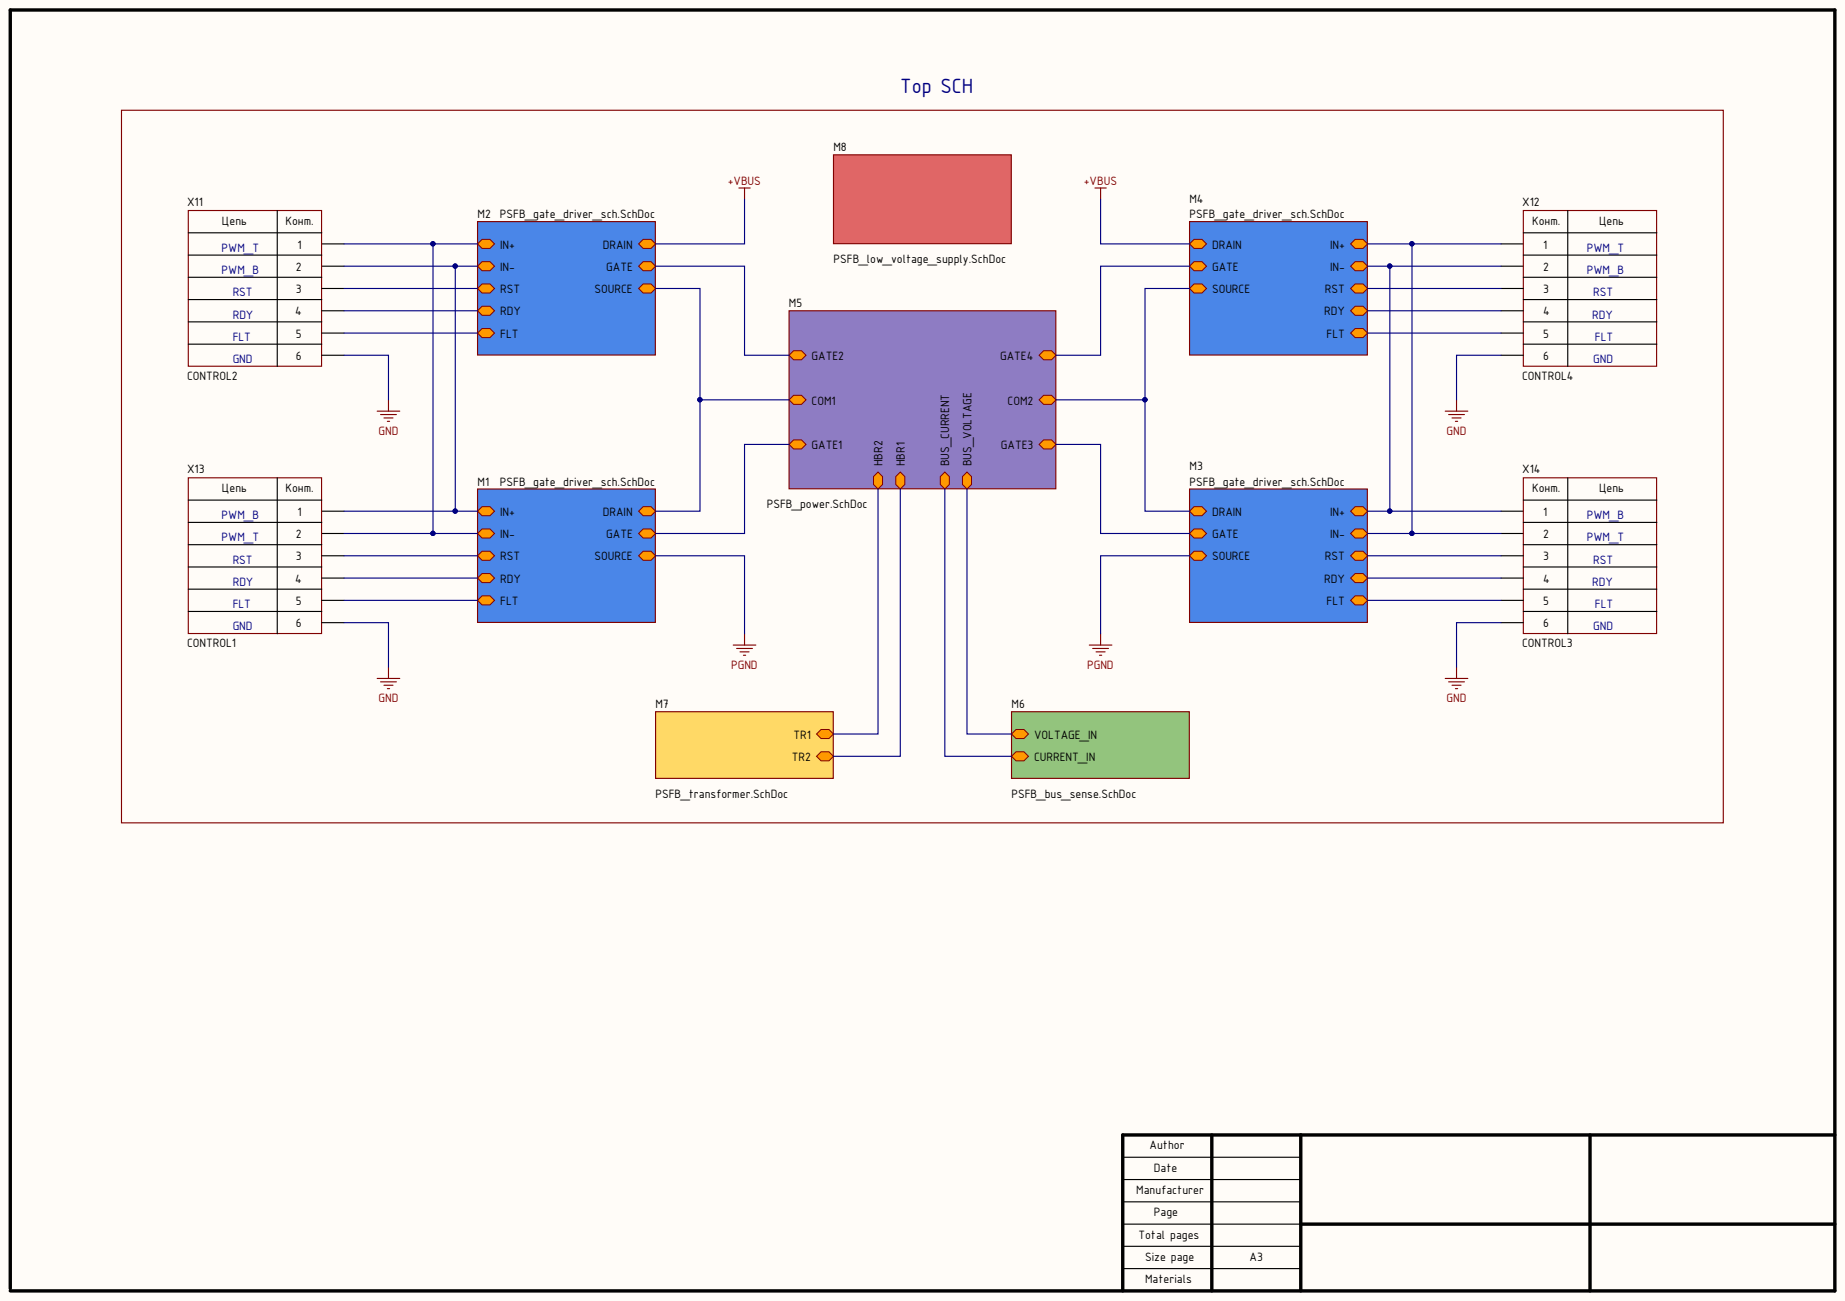
[picture p8: page 5]

Author

Date

Manufacturer

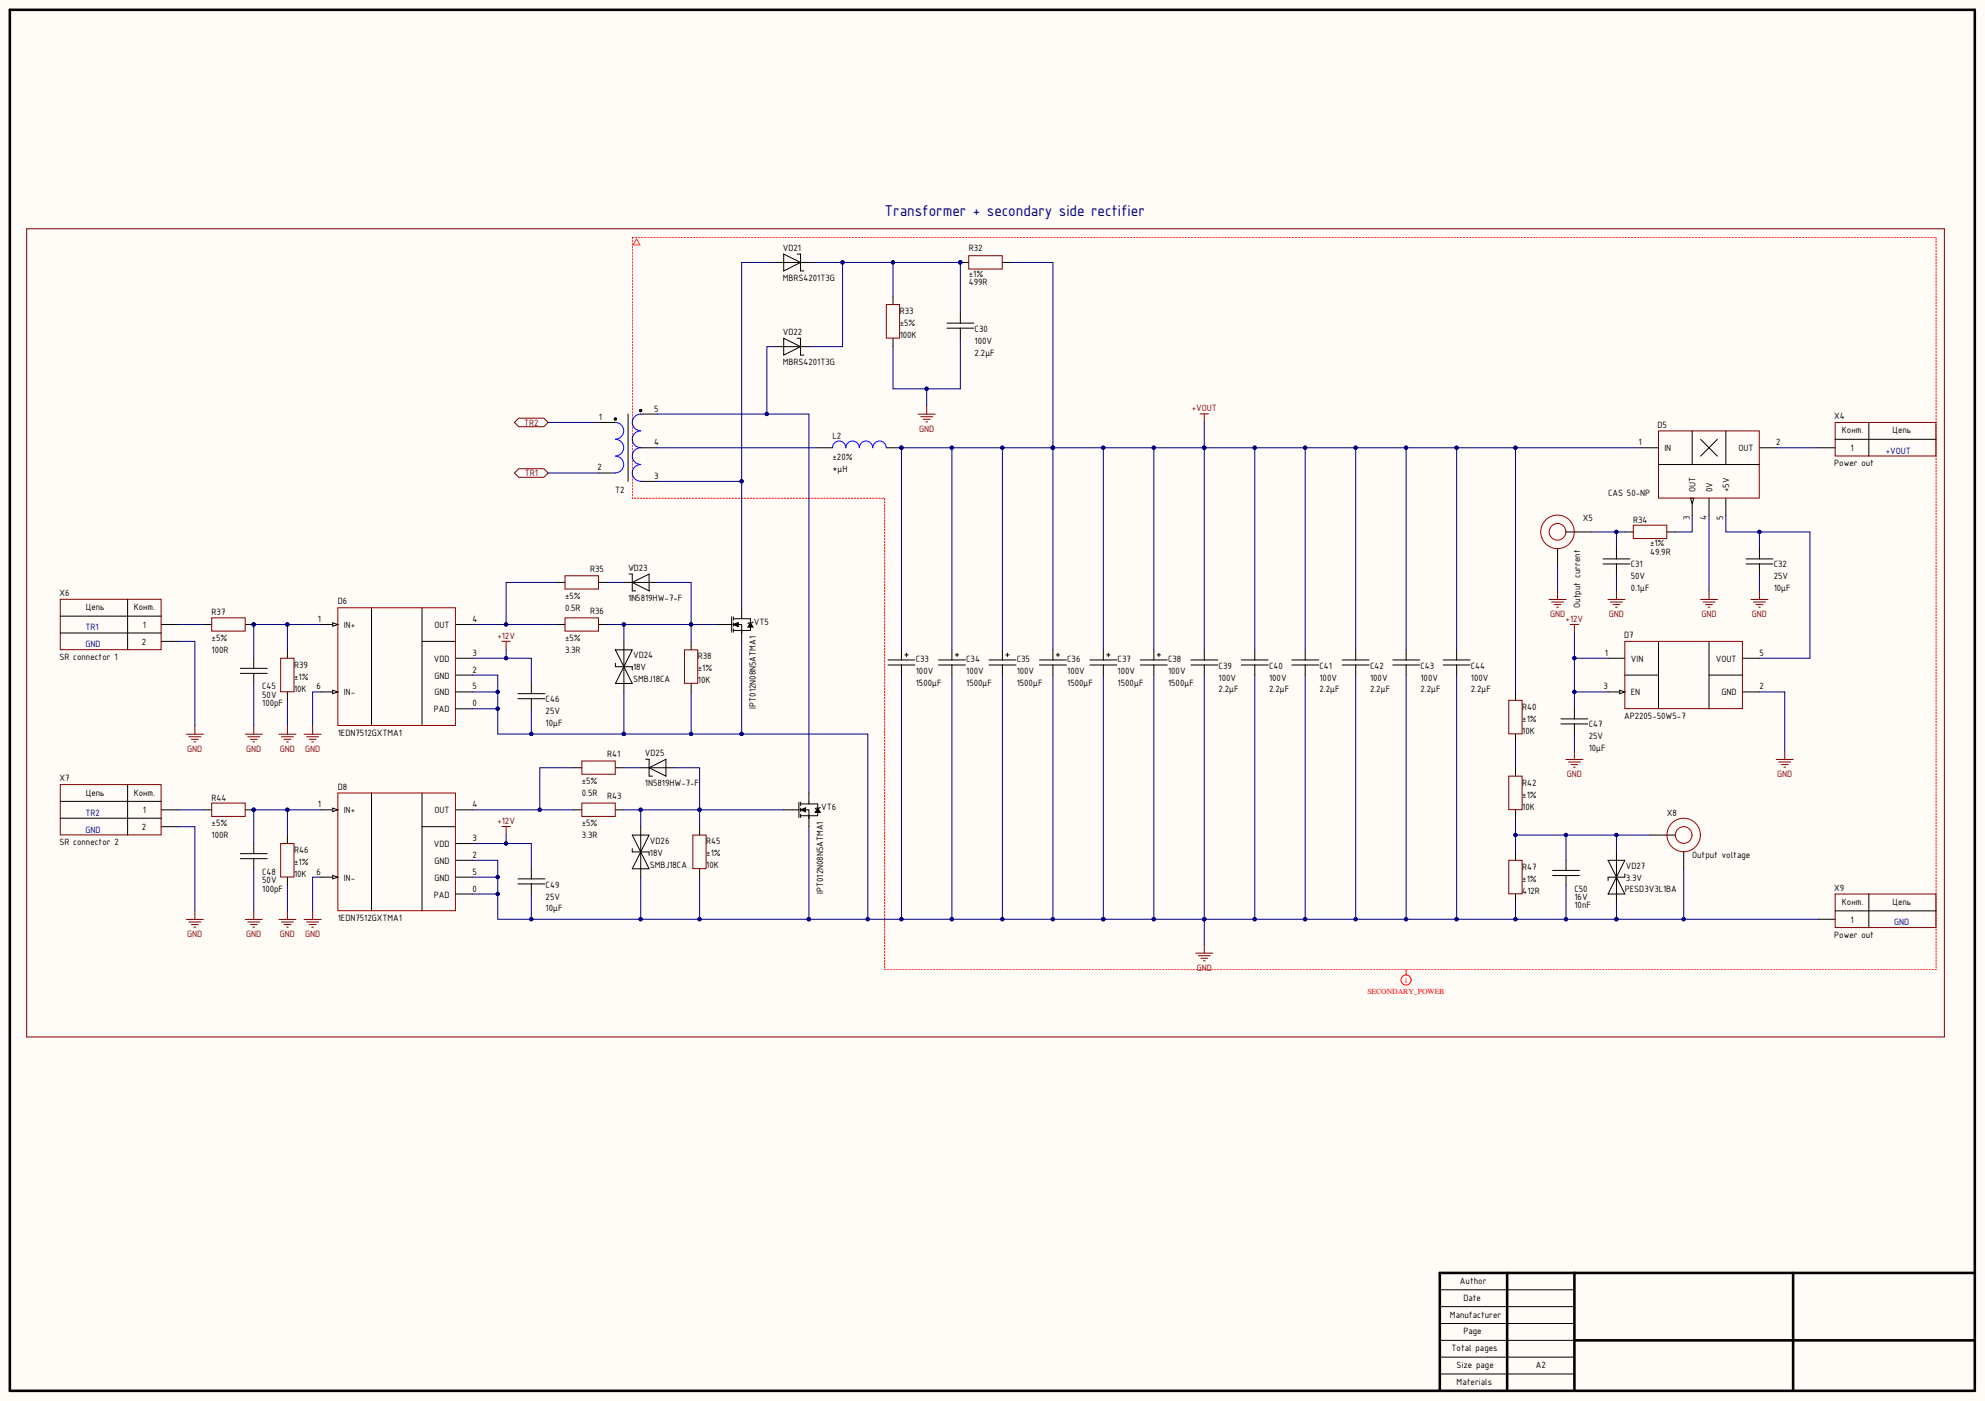
[picture p9: page 6]

Transformer + secondary side rectifier

Конт . | Цепь

+VOUT

Цепь | Конт .

GND

Author

Date

Manufacturer
