Tesla900/CP_Inverter/PFC/Hardware/Info/CP_inverter_Schematic.pdf

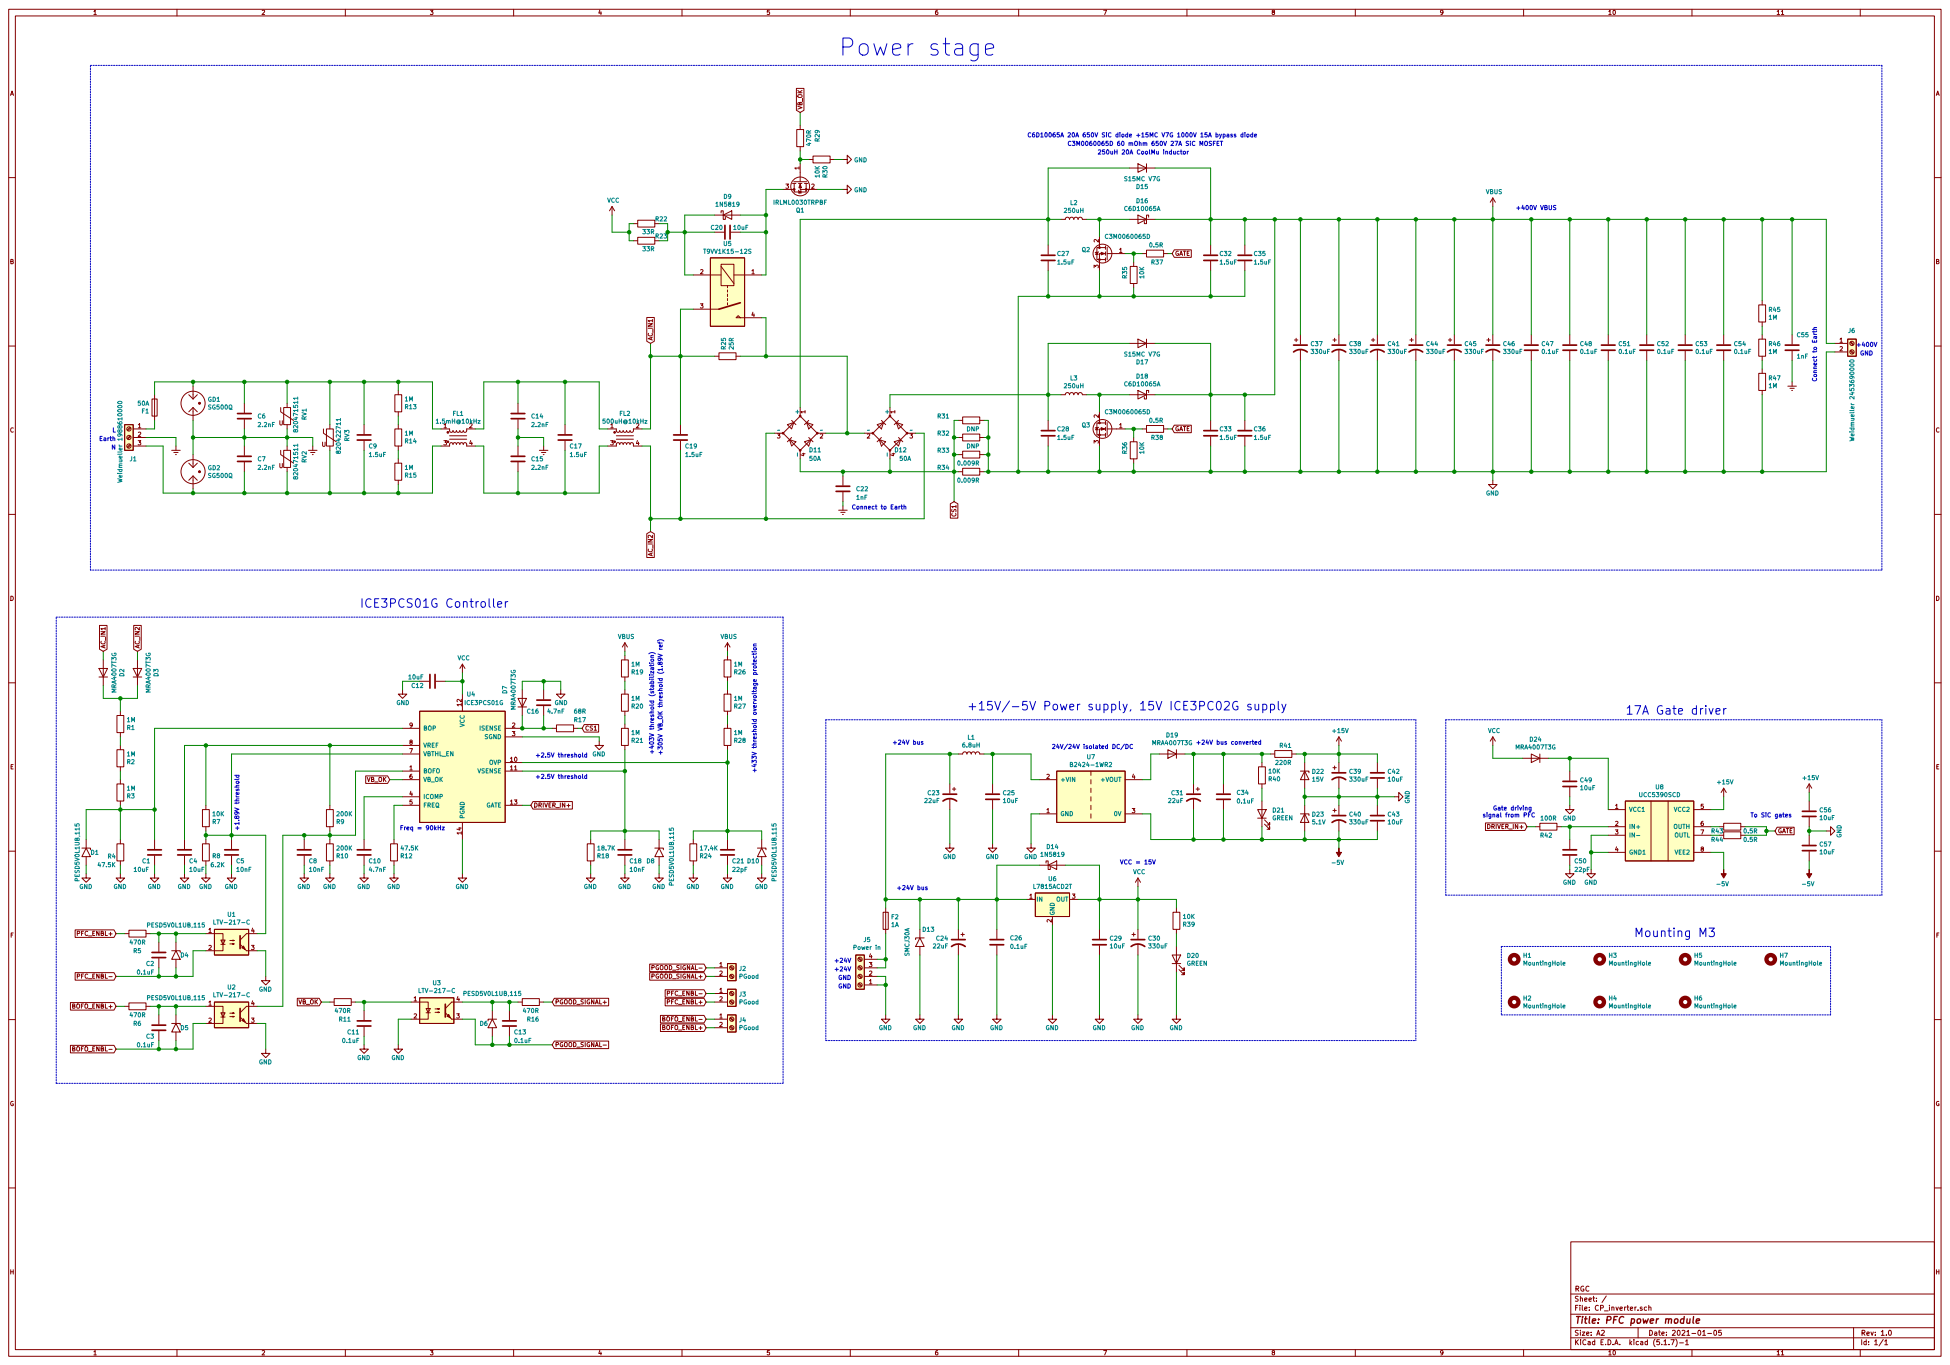
[picture p10: page 1]

Power stage
C3M0060065D 60 mOhm 650V 27A SiC MOSFET +15V/-5V Power supply, 15V ICE3PC02G supply

C6D10065A 20A 650V SiC diode +15MC V7G 1000V 15A bypass diode

File: CP_inverter.sch Sheet: / RGC

Id: 1/1 Title: PFC power module
