Tesla900/CP_Inverter/PSFB/Hardware/ProductionFiles/assembly/PSFB_Draftsman.PDF

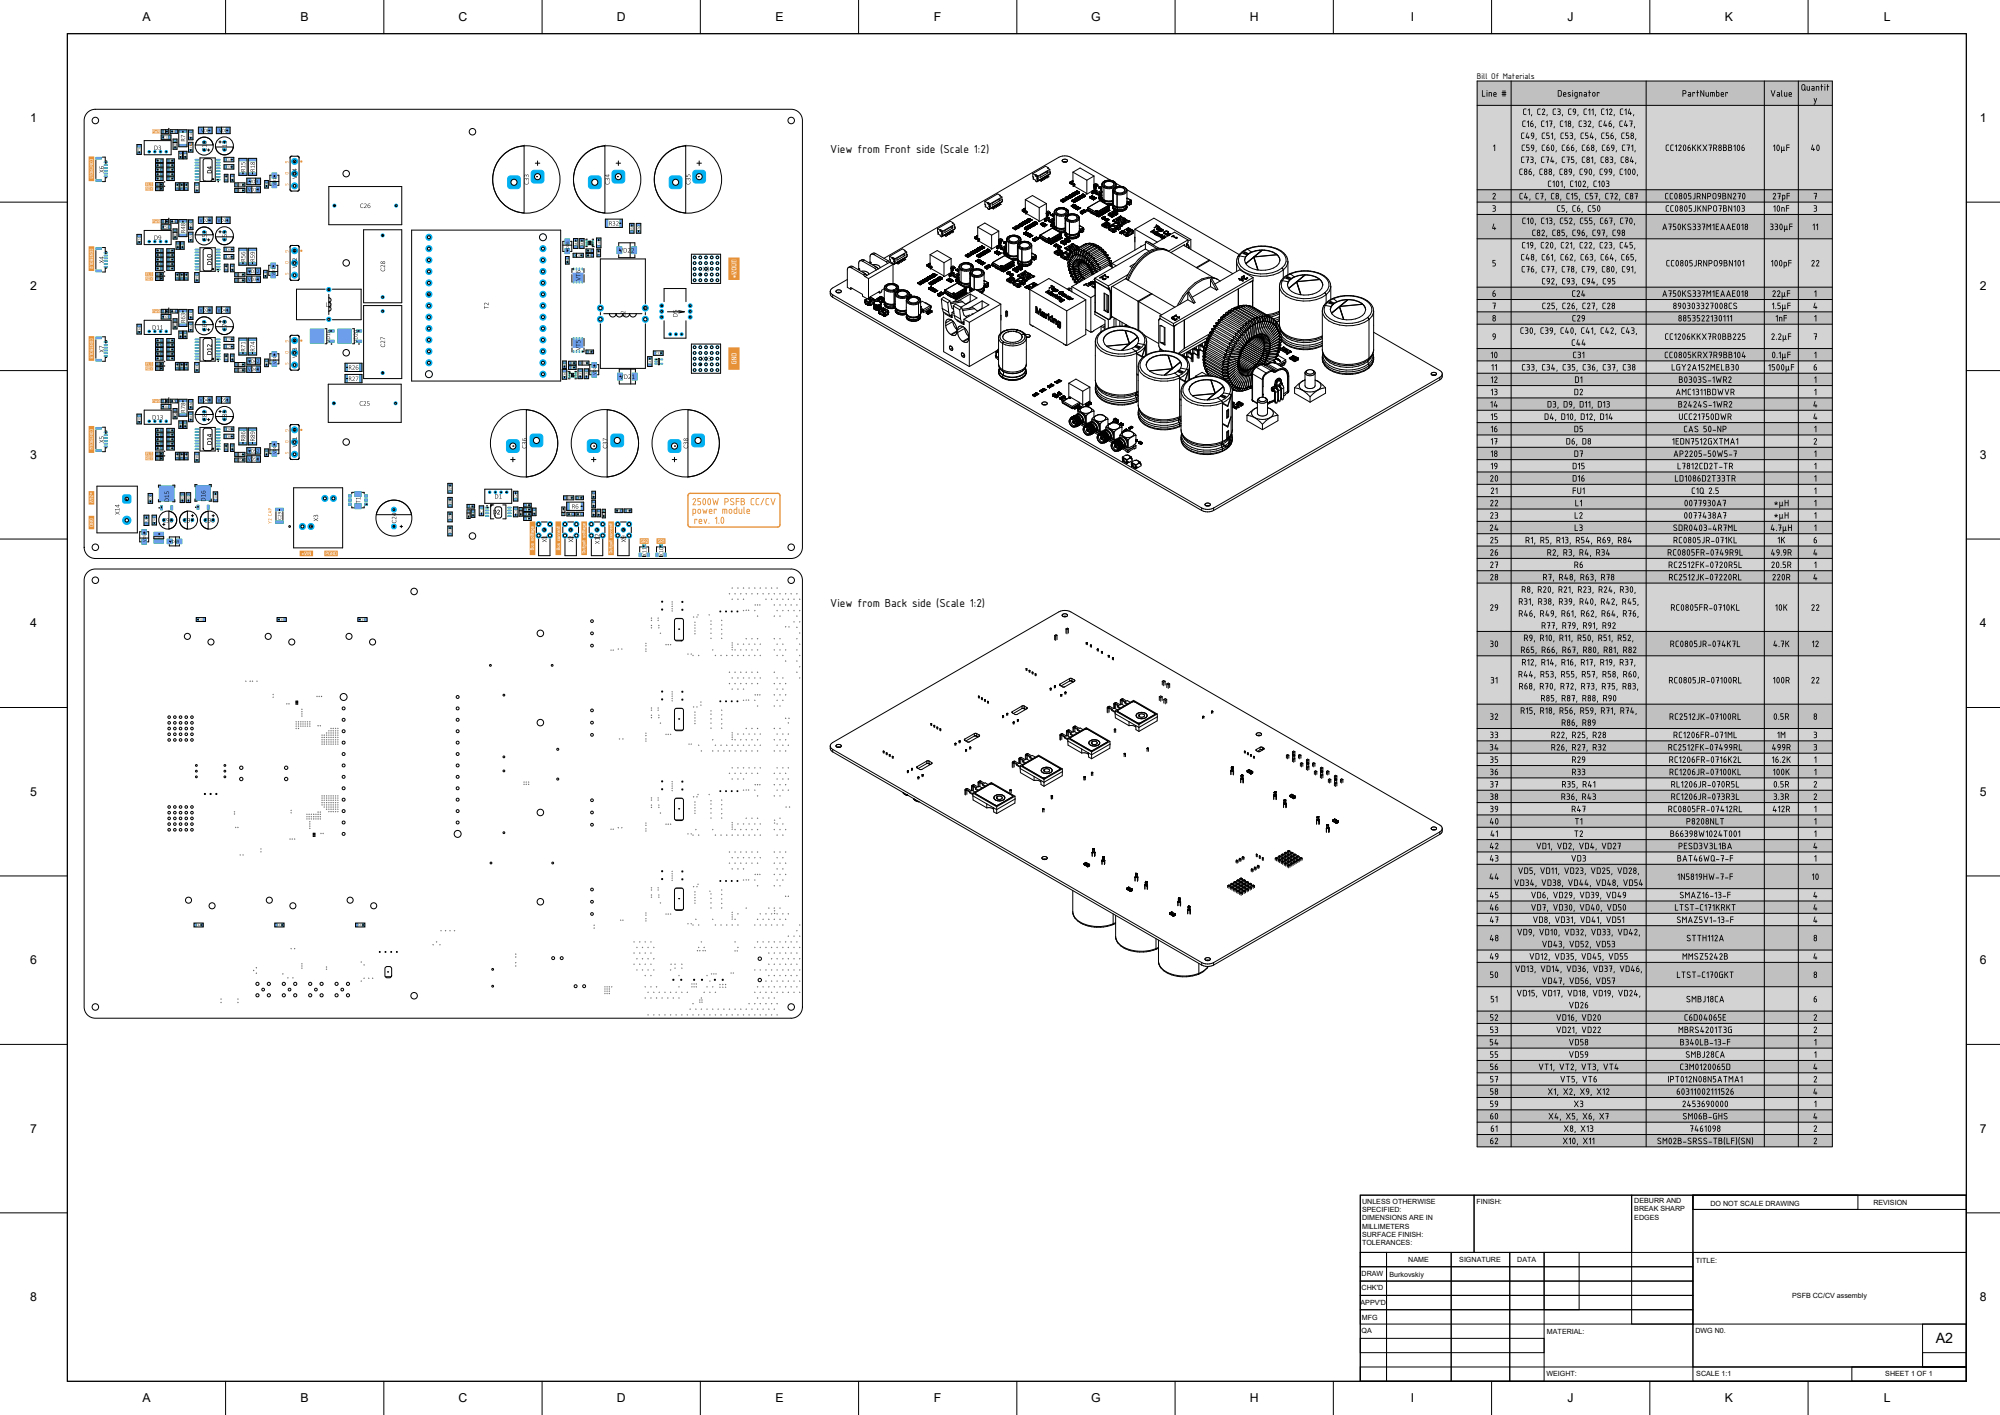
[picture p11: page 1]

View from Front side (Scale 1:2)

View from Back side (Scale 1:2)

PSFB CC/CV assembly
