Tesla900/CP_Inverter/PSFB/Hardware/ProductionFiles/assembly/PSFB_Assembly Drawings.PDF

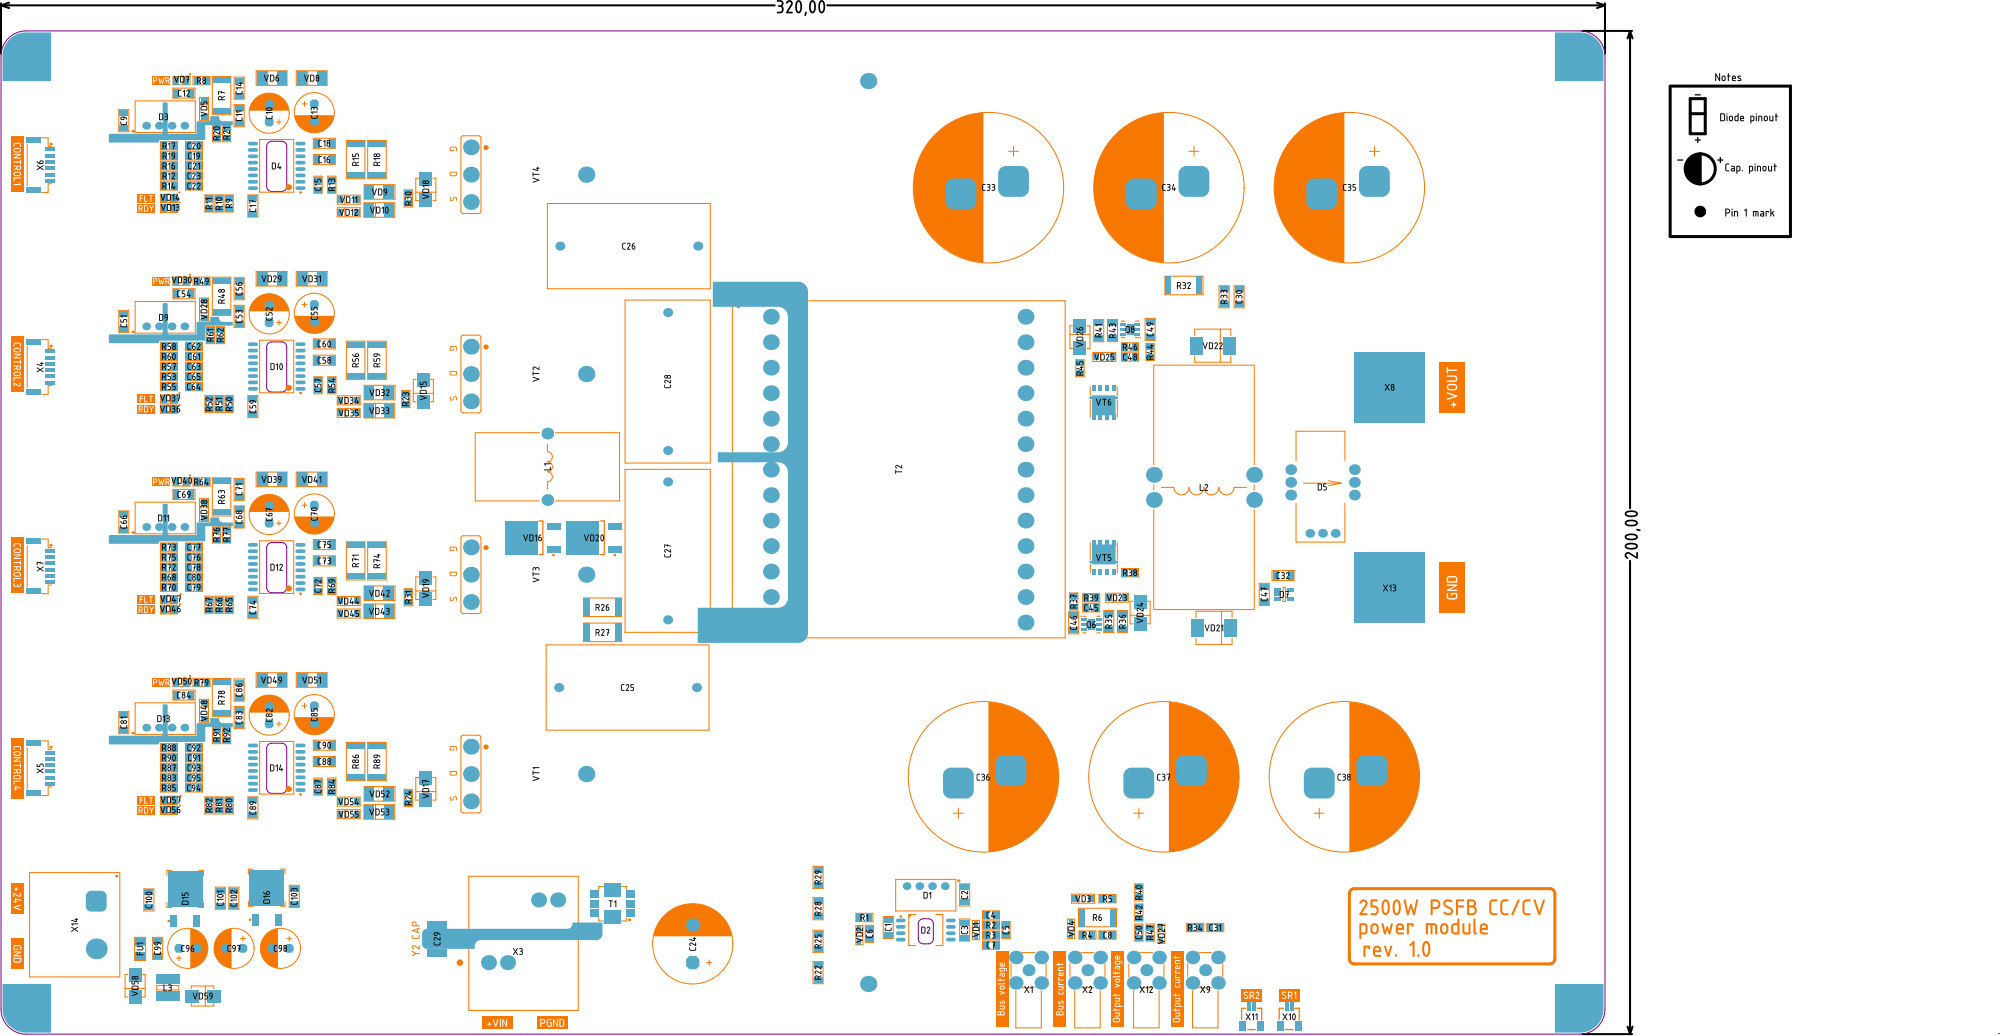
[picture p20: page 1]

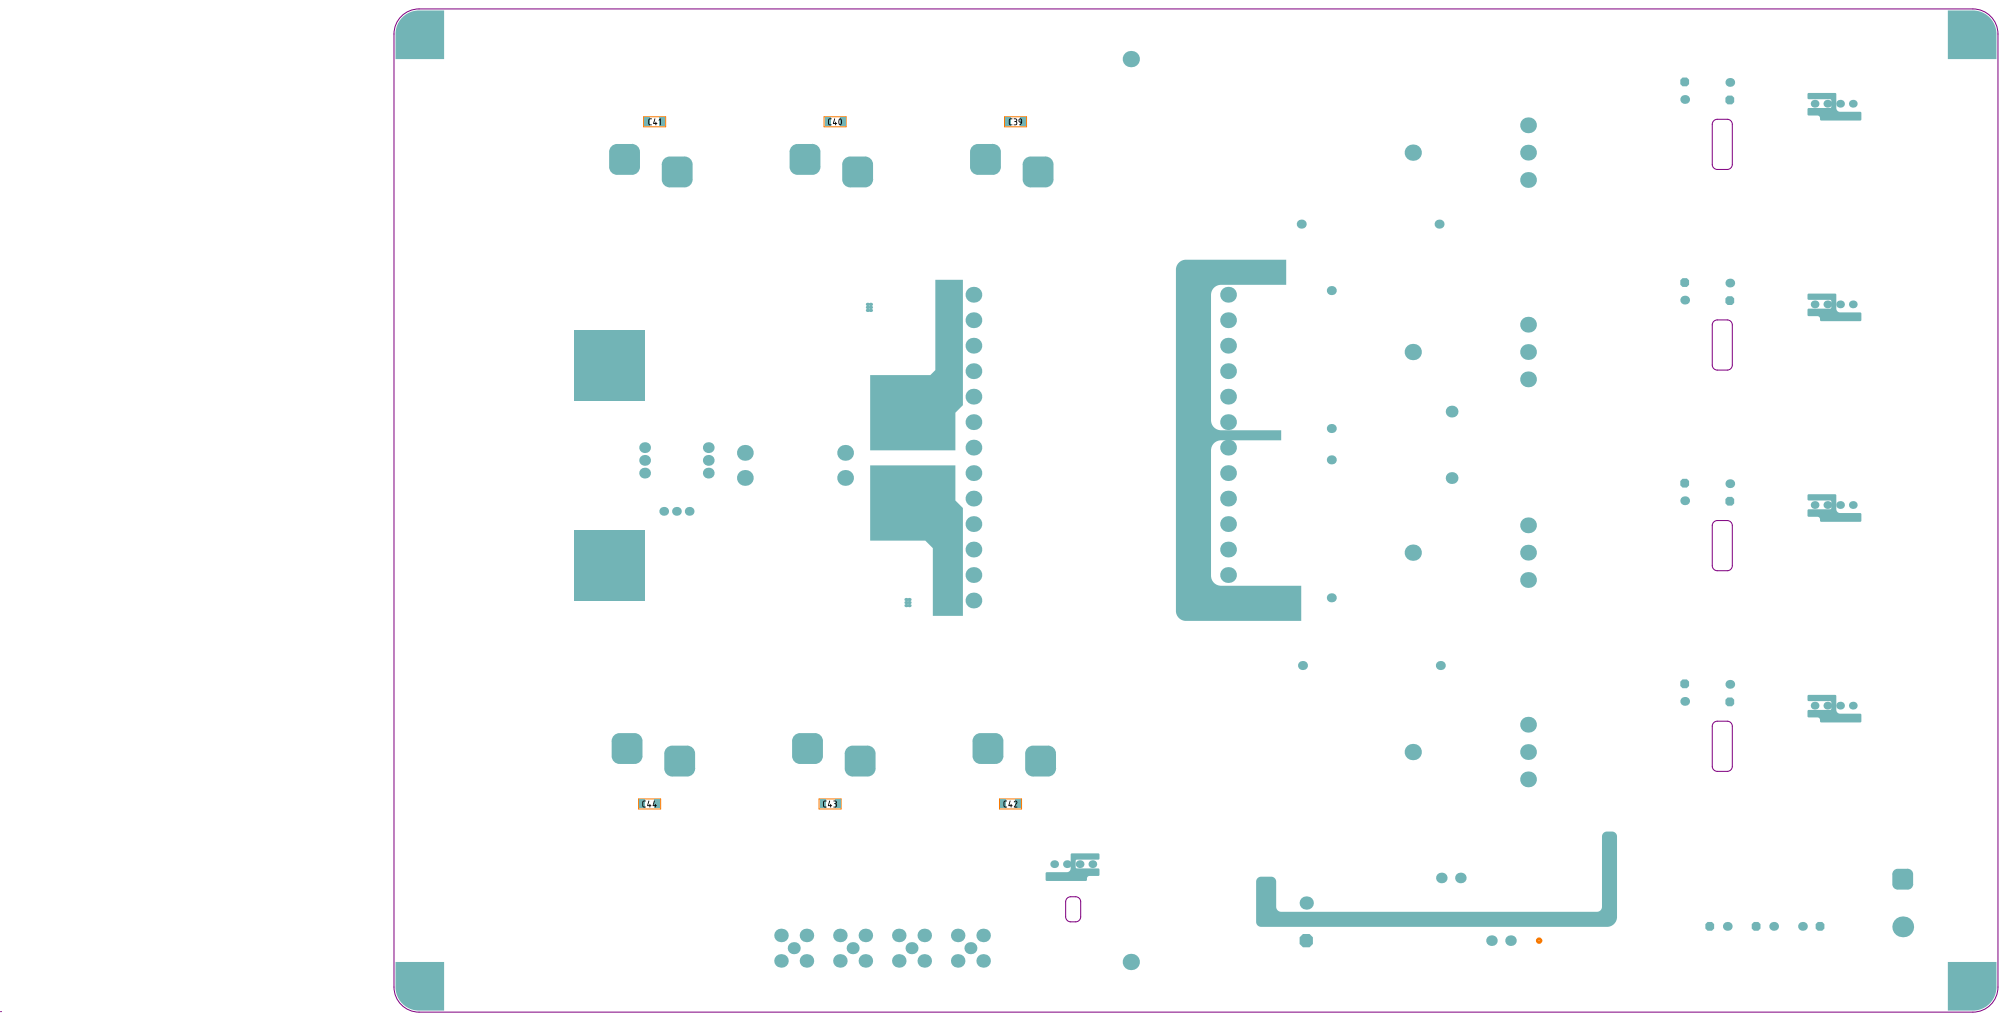
[picture p21: page 2]
