Tesla900/CP_Inverter/PSFB/Hardware/ProductionFiles/assembly/PSFB_BoardLayout.PDF

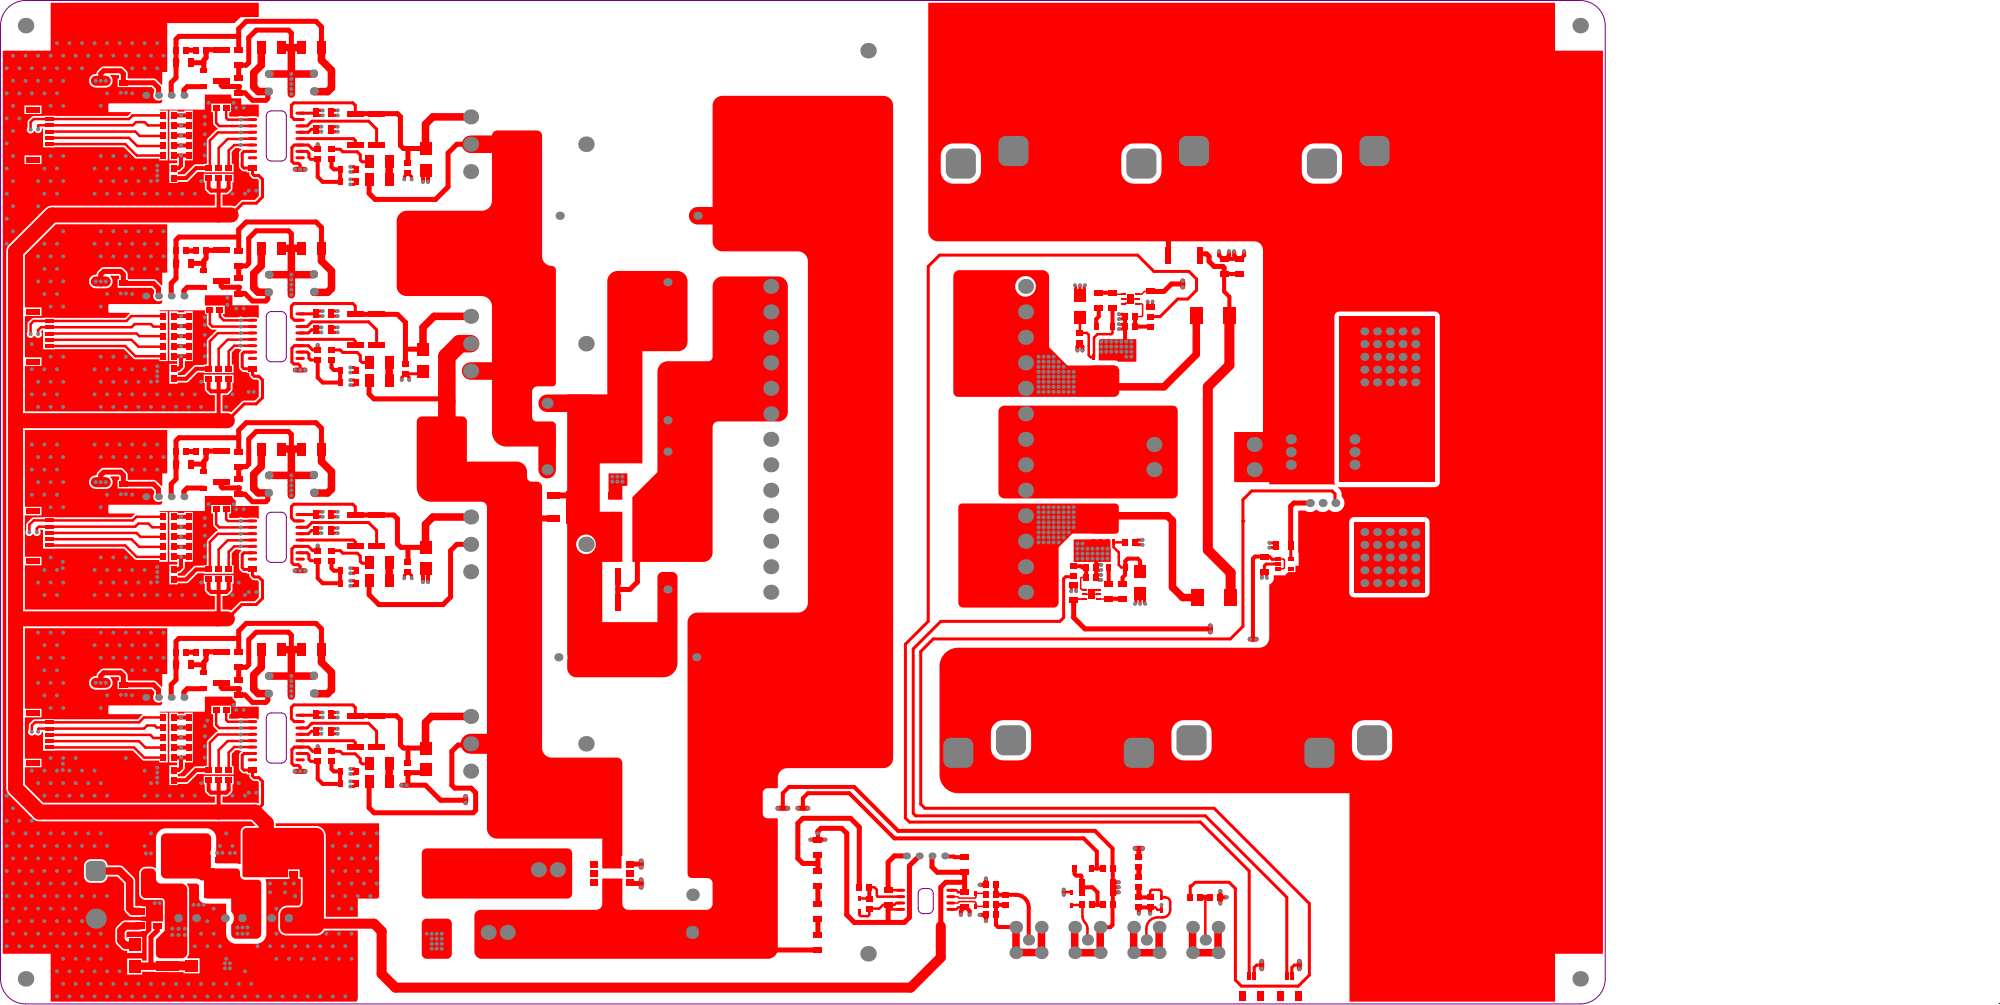
[picture p22: page 1]

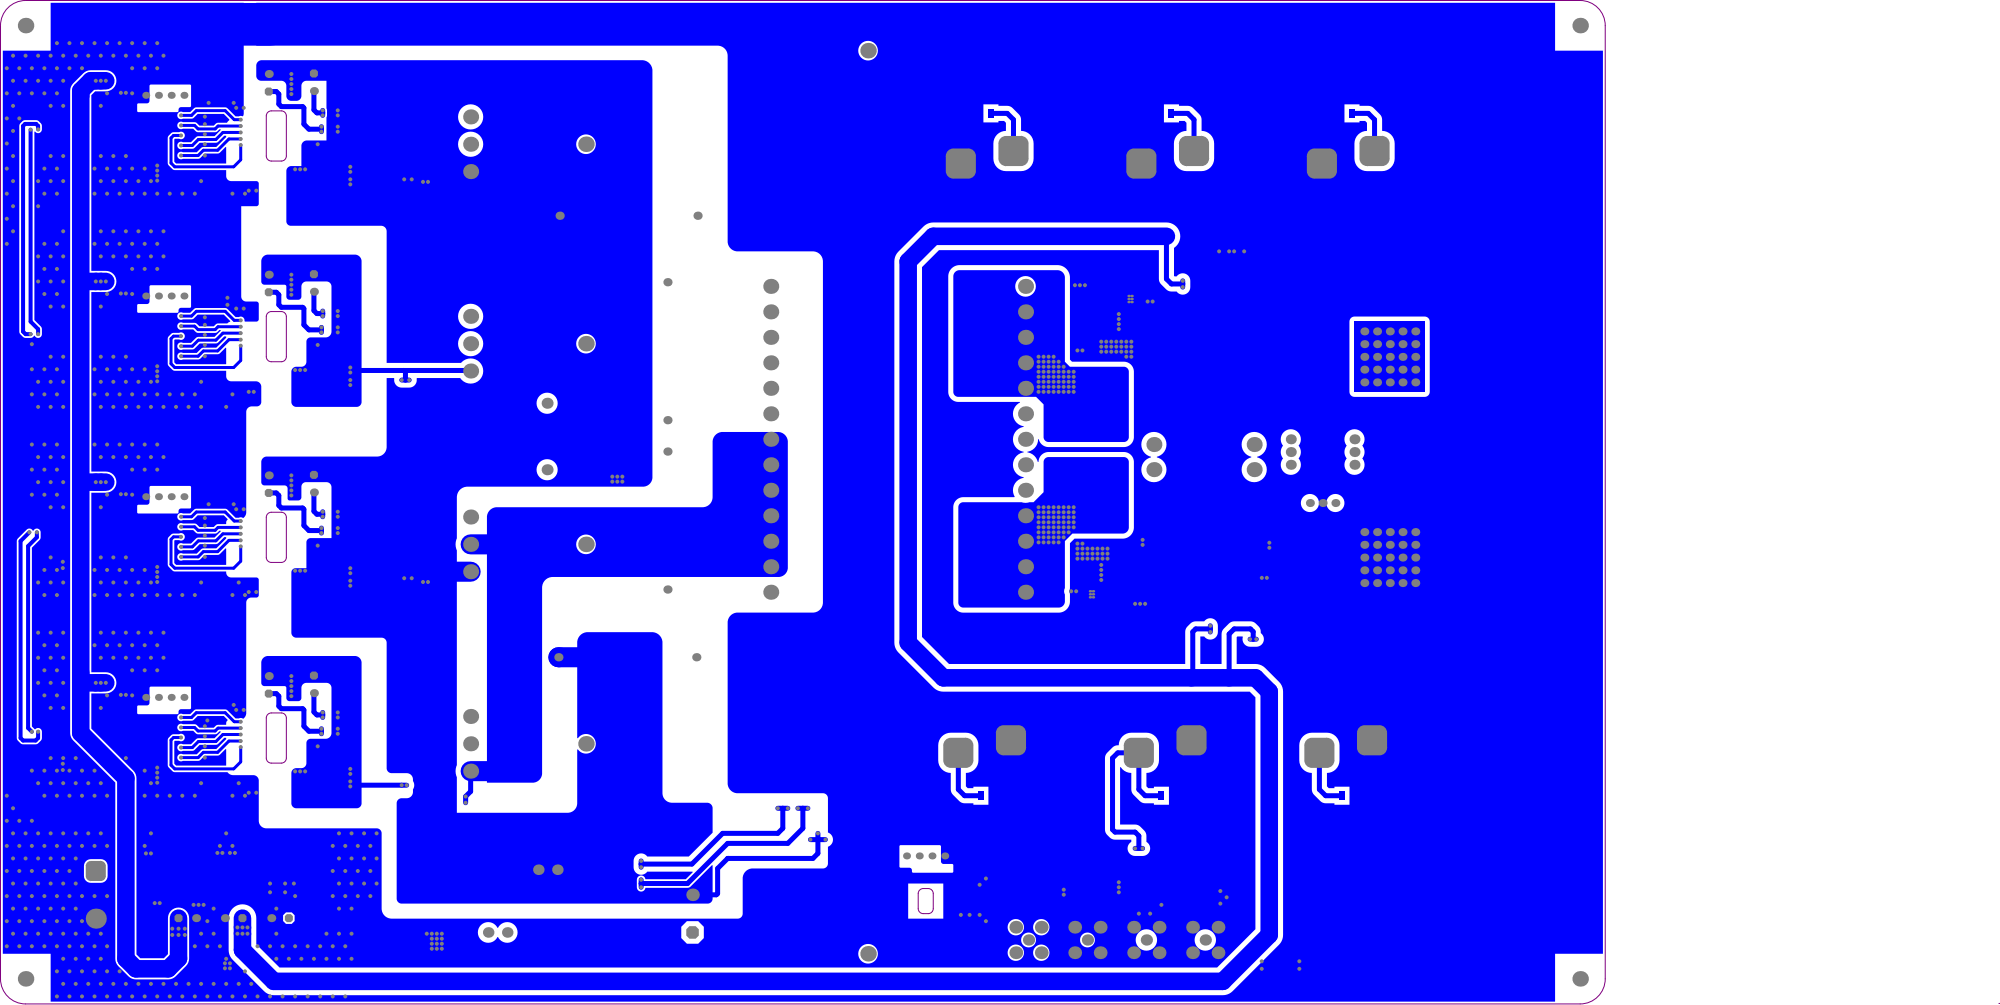
[picture p23: page 2]
