Tesla900/CP_Inverter/(list of files, drawings)

Other design files:
PSFB/Hardware/PSFB.PrjPcb
PSFB/Hardware/PSFB_bus_sense.SchDoc
PSFB/Hardware/PSFB_gate_driver_sch.SchDoc
PSFB/Hardware/PSFB_low_voltage_supply.SchDoc
PSFB/Hardware/PSFB_power.SchDoc
PSFB/Hardware/PSFB_top_level.SchDoc
PSFB/Hardware/PSFB_transformer.SchDoc
