Tesla900/CP_Inverter/PFC/Hardware/CP_inverter.kicad_pcb

## KiCad design PFC/Hardware/CP_inverter.kicad_pcb (2021-02-27)

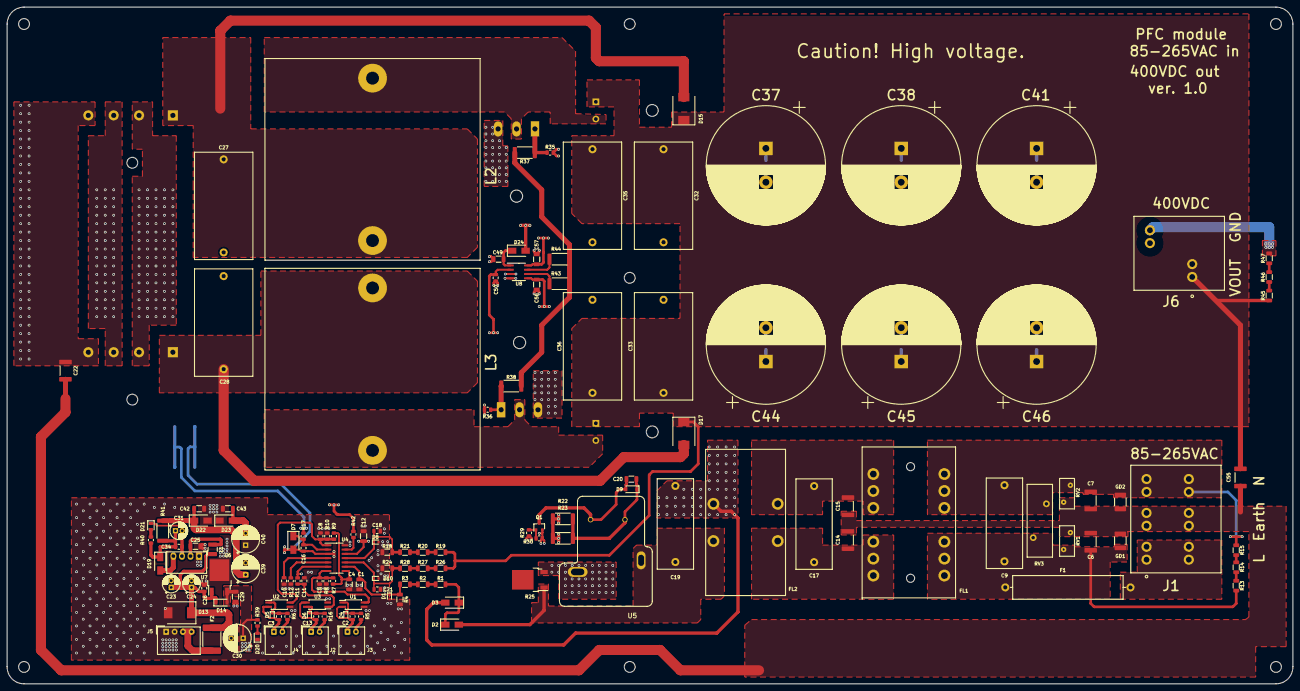
[picture p24: board CP_inverter.kicad_pcb from above]

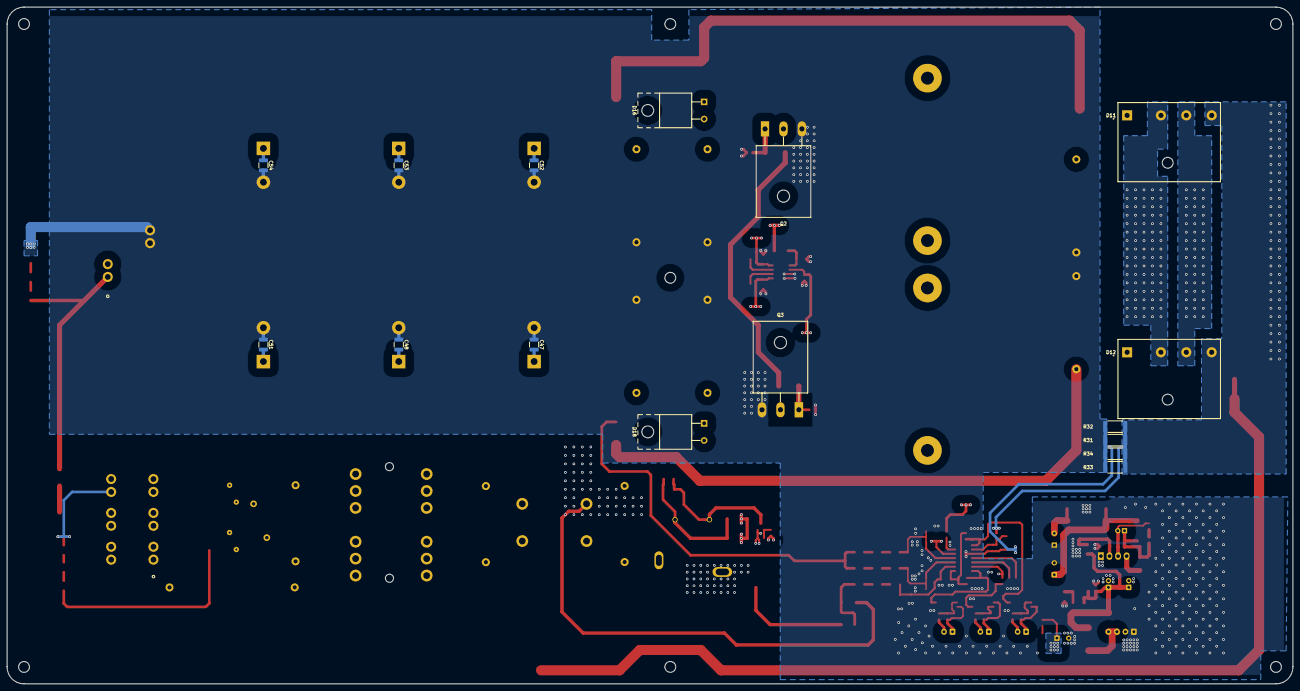
[picture p25: board CP_inverter.kicad_pcb from below]

Board: 4 copper layers, 380.0 x 200.0 mm, 164 parts (16 on the bottom side), 68 nets.

Parts:
C1, C4, C12, C20, C25, C29, C42, C43, C49, C56, C57: 10uF; C_1206_3216Metric
C2, C3, C11, C13, C26, C34: 0.1uF; C_0805_2012Metric
C5, C8, C18: 10nF; C_0805_2012Metric
C6, C7, C14, C15: 2.2nF; C_2211_5728Metric
C9, C17, C19: 1.5uF; C_Rect_L26.5mm_W10.5mm_P22.50mm_MKS4
C10, C16: 4.7nF; C_0805_2012Metric
C21, C50: 22pF; C_0805_2012Metric
C22, C55: 1nF; C_2211_5728Metric
C23, C24, C31: 22uF; CP_Radial_D5.0mm_P2.00mm
C27, C28, C32, C33, C35, C36: 1.5uF; C_Rect_L31.5mm_W17.0mm_P27.50mm_MKS4
C30, C39, C40: 330uF; CP_Radial_D8.0mm_P3.50mm
C37, C38, C41, C44, C45, C46: 330uF; CP_Radial_D35.0mm_P10.00mm_SnapIn
C47, C48, C51, C52, C53, C54: 0.1uF; C_1210_3225Metric
D1, D4, D5, D6, D8, D10: PESD5V0L1UB,115; D_SOD-523
D2, D3, D7, D19, D24: MRA4007T3G; D_SMA
D9, D14: 1N5819; D_SOD-123
D11, D12: 50A; CONV_TS50P07GHD2G
D13: SMCJ30A; D_SMC
D15, D17: S15MC V7G; D_SMC
D16, D18: C6D10065A; TO-220-2_Horizontal_TabUp
D20, D21: GREEN; LED_0805_2012Metric
D22: 15V; D_SMA
D23: 5.1V; D_SMA
F1: 50A; Fuse_SunFuse-6HP
F2: 1A; Fuse_2920_7451Metric
FL1: 1.5mH@10kHz; CommonMode_Wuerth_WE-CMBNC
FL2: 500uH@10kHz; CommonMode_Wuerth_WE-CMB-XXL
GD1, GD2: SG500Q; GDT_1812
H1, H2, H3, H4, H5, H6, H7: MountingHole; MountingHole_3.2mm_M3_DIN965
J1: Weidmueller 1988610000; Weidmueller_1988610000
J2, J3, J4: PGood; Molex_SPOX_5268-02A_1x02_P2.50mm_Horizontal
J5: Power in; Molex_SPOX_5268-04A_1x04_P2.50mm_Horizontal
J6: Weidmueller 2453690000; Weidmueller_2453690000
L1: 6.8uH; L_1210_3225Metric
L2, L3: 250uH; D62mm_P32.6mm_x2
Q1: IRLML0030TRPBF; SOT-23
Q2, Q3: C3M0060065D; TO-247-3_Horizontal_TabUp
R1, R2, R3, R13, R14, R15, R19, R20, R21, R26, R27, R28, R45, R46, R47: 1M; R_1206_3216Metric
R4: 47.5K; R_1206_3216Metric
R5, R6, R11, R16, R29: 470R; R_0805_2012Metric
R7, R30, R35, R36, R39, R40: 10K; R_0805_2012Metric
R8: 6.2K; R_0805_2012Metric
R9, R10: 200K; R_0805_2012Metric
R12: 47.5K; R_0805_2012Metric
R17: 68R; R_0805_2012Metric
R18: 18.7K; R_1206_3216Metric
R22, R23: 33R; R_2512_6332Metric
R24: 17.4K; R_1206_3216Metric
R25: 25R; DPAK_Resistor
R31, R32: DNP; R_2512_6332Metric
R33, R34: 0.009R; R_2512_6332Metric
R37, R38, R43, R44: 0.5R; R_2512_6332Metric
R41: 220R; R_2512_6332Metric
R42: 100R; R_0805_2012Metric
RV1, RV2: 820471511; RV_Disc_D9mm_W4.4mm_P5mm
RV3: 820422711; RV_Disc_D21.5mm_W7.5mm_P10mm
U1, U2, U3: LTV-217-C; SO-4_4.4x2.3mm_P1.27mm
U4: ICE3PCS01G; SOIC-14_3.9x8.7mm_P1.27mm
U5: T9VV1K15-12S; RELAY_T9VV1K15-12S
U6: L7815ACD2T; TO-252-2
U7: B2424-1WR2; Converter_DCDC_Murata_MEE1SxxxxSC_THT
U8: UCC5390SCD; SOIC-8_3.9x4.9mm_P1.27mm

Connections:
+15V: C39.1, C42.1, C56.1, D22.1, R41.1, U8.5
-5V: C31.2, C34.2, C40.2, C43.2, C57.2, D21.1, D23.2, U7.3, U8.8
AC_IN1: C19.1, D2.2, FL2.2, R25.1, U5.3
AC_IN2: C19.2, D3.2, D11.3, D12.3, FL2.4
BOFO_ENBL+: J4.2, R6.1
BOFO_ENBL-: C3.2, D5.2, J4.1, U2.2
CS1: C22.1, D11.4, D12.4, R17.2, R31.1, R32.1, R33.1, R34.1
DRIVER_IN+: R42.1, U4.13
Earth: C6.2, C7.1, C14.2, C15.1, C22.2, C55.2, GD1.1, GD2.3, J1.2, RV1.2, RV2.1
GATE: R37.2, R38.2, R43.2, R44.2
GND: C1.2, C4.2, C5.2, C8.2, C10.2, C11.2, C12.1, C16.1, C18.2, C21.2, C23.2, C24.2, C25.2, C26.2, C27.2, C28.2, C29.2, C30.2, C32.2, C33.2, C35.2, C36.2, C37.2, C38.2, C39.2, C40.1, C41.2, C42.2, C43.1, C44.2, C45.2, C46.2, C47.2, C48.2, C49.2, C50.2, C51.2, C52.2, C53.2, C54.2, C56.2, C57.1, D1.2, D7.2, D8.2, D10.2, D13.2, D20.1, D22.2, D23.1, J5.1, J5.2, J6.2, Q1.2, Q2.3, Q3.3, R4.1, R8.1, R10.1, R12.1, R18.1, R24.1, R30.1, R31.2, R32.2, R33.2, R34.2, R35.2, R36.2, R47.2, U1.3, U2.3, U3.2, U4.3, U4.14, U6.2, U7.1, U8.3, U8.4
unnamed: C1.1, D1.1, R3.1, R4.2, U4.9
unnamed: C2.1, D4.1, R5.2, U1.1
unnamed: C3.1, D5.1, R6.2, U2.1
unnamed: C4.1, R7.2, R9.2, U4.8
unnamed: C5.1, R7.1, R8.2, U1.4, U4.7
unnamed: C6.1, C9.1, F1.2, FL1.1, GD1.3, R13.2, RV1.1, RV3.1
unnamed: C7.2, C9.2, FL1.3, GD2.1, J1.3, R15.1, RV2.2, RV3.2
unnamed: C8.1, R9.1, R10.2, U2.4, U4.1
unnamed: C10.1, U4.4
unnamed: C11.1, R11.1, U3.1
unnamed: C13.1, D6.1, R16.2, U3.4
unnamed: C14.1, C17.1, FL1.2, FL2.1
unnamed: C15.2, C17.2, FL1.4, FL2.3
unnamed: C16.2, D7.1, R17.1, U4.2
unnamed: C18.1, D8.1, R18.2, R21.1, U4.11
unnamed: C20.1, D9.1, R22.1, R23.1, U5.2
unnamed: C20.2, D9.2, Q1.3, U5.1
unnamed: C21.1, D10.1, R24.2, R28.1, U4.10
unnamed: C23.1, C24.1, C26.1, D13.1, D14.1, F2.1, L1.1, U6.1
unnamed: C25.1, L1.2, U7.2
unnamed: C27.1, D11.1, D15.2, L2.1
unnamed: C28.1, D12.1, D17.2, L3.1
unnamed: C31.1, C34.1, D19.1, R40.2, R41.2
unnamed: C49.1, D24.1, U8.1
unnamed: C50.1, R42.2, U8.2
unnamed: D2.1, D3.1, R1.2
unnamed: D11.2, D12.2, R25.2, U5.4
unnamed: D16.2, L2.2, Q2.2
unnamed: D18.2, L3.2, Q3.2
unnamed: D19.2, U7.4
unnamed: D20.2, R39.1
unnamed: D21.2, R40.1
unnamed: F1.1, J1.1
unnamed: F2.2, J5.3, J5.4
unnamed: Q1.1, R29.2, R30.2
unnamed: Q2.1, R35.1, R37.1
unnamed: Q3.1, R36.1, R38.1
unnamed: R1.1, R2.2
unnamed: R2.1, R3.2
unnamed: R12.2, U4.5
unnamed: R13.1, R14.2
unnamed: R14.1, R15.2
unnamed: R19.1, R20.2
unnamed: R20.1, R21.2
unnamed: R26.1, R27.2
unnamed: R27.1, R28.2
unnamed: R43.1, U8.6
unnamed: R44.1, U8.7
unnamed: R45.2, R46.1
unnamed: R46.2, R47.1
PFC_ENBL+: J3.2, R5.1
PFC_ENBL-: C2.2, D4.2, J3.1, U1.2
PGOOD_SIGNAL+: J2.2, R16.1
PGOOD_SIGNAL-: C13.2, D6.2, J2.1, U3.3
VBUS: C32.1, C33.1, C35.1, C36.1, C37.1, C38.1, C41.1, C44.1, C45.1, C46.1, C47.1, C48.1, C51.1, C52.1, C53.1, C54.1, C55.1, D15.1, D16.1, D17.1, D18.1, J6.1, R19.2, R26.2, R45.1
VB_OK: R11.2, R29.1, U4.6
VCC: C12.2, C29.1, C30.1, D14.2, D24.2, R22.2, R23.2, R39.2, U4.12, U6.3
