Tesla900/CP_Inverter/(commit log)

2021-01-17 new: Schematic ready
    [CP_inverter.kicad_pcb, CP_inverter.sch]
2021-01-21 new: Rev. 1.0 common phases
    [CP_inverter.sch]
2021-01-22 new: Rev. 1.0 common phases finish
    [CP_inverter.sch]
2021-01-24 new: Work in progress
    [CP_inverter.kicad_pcb, CP_inverter.sch]
2021-01-28 new: Work in progress, filter layout
    [CP_inverter.kicad_pcb, CP_inverter.sch]
2021-02-01 new: first rev
    [CP_inverter.kicad_pcb]
2021-02-02 new: rev. 1.0. fixes
    [CP_inverter.kicad_pcb, CP_inverter.sch]
2021-02-02 new: production files added
    [CP_Inverter_BOM.xlsx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]
2021-02-27 new: PSFB files added
    [CP_Inverter_BOM.xlsx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]
2021-03-02 new: PSFB PCB progress
    [PSFB.PrjPcb, PSFB_gate_driver_sch.SchDoc, PSFB_low_voltage_supply.SchDoc, PSFB_power.SchDoc, PSFB_top_level.SchDoc, PSFB_transformer.SchDoc]
2021-03-08 new: PSFB PCB rev. 1.0
    [CP_Inverter_BOM.xlsx, PSFB.PrjPcb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]
2021-03-11 new: PSFB PCB rev. 1.0 hotfix
    [CP_Inverter_BOM.xlsx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]
